acssca/Oxygen/CCCF GB/GB4717/2020/02_草案稿解析/GB4717-201X CCCF-update_20181226.pptx

- GB4717-201X Key Changes
- 2018.12.26

## 20181221 国标讨论会议重点摘要

- 指示灯及对应文字的展现形式在保持总体布局、功能的前提下，可以调整其大小，形状。
- 增加事件确认按键，对所有事件作确认（可以有全局确认和单一确认），确认后的事件带有已确认文字标识，不影响指示灯和蜂鸣器状态。确认操作与手自动操作无关。火警确认可通过操作联动启动按钮来完成，其他事件仍需做确认操作。
- 检查功能更改为由按键实现，不设操作级别，设检查指示灯。
- 手自动切换操作和联动启动按键的功能要求与上一版报批稿一致。（钥匙设为手动档，联动启动按钮按下后系统切换为自动状态。在下一次复位后，按照钥匙的实际位置，更新系统的手自动状态。）
- 联动启动按键的颜色更改为绿色。
- 屏蔽和监管仍作为可选功能。
- 保留‘系统故障’指示灯的描述。


联动
启动

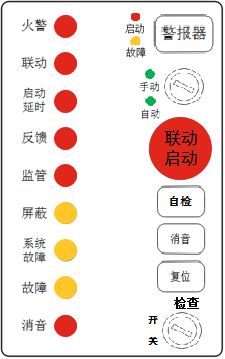
[picture p16: figure]
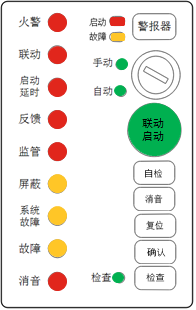
[picture p17: figure]
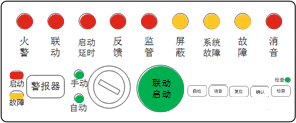
[picture p18: figure]

## 20181221 国标讨论会议重点摘要

- 统一外设部件的名称，全称和缩写，以及所属的事件类别。编码方式不做统一规定。
- 控制器软件界面不做强制统一要求。
- 增加‘调试接口’，使用企业专用工具，使控制器进入调试模式， 此阶段产生的事件信息应标识为调试信息。（可选）
- 在控制器上植入使用说明书或操作指南。（后续考虑）
- 为集中型控制器增加‘复视显示器’，尺寸大于17寸。应能通过该显示器实现集中控制器的所有功能。
- 历史记录总数上限为所接探测器数量的100倍，事件分类存储。（征询意见）
- 多线输出的启停按钮，应有物理方式防止两个按键同时按下，不接受同时按下后不输出的方式。

标签

## 20181207操作面板更新

联动
启动

更新内容：
- 增加自检按钮
- 移除检查指示灯
- 调整按键布局
- 调整指示灯和文字标识


联动
启动

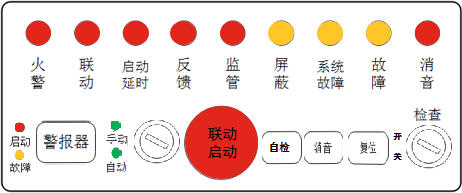
[picture p19: figure]

现场反馈问题：
- 联动启动按钮和手自动钥匙的状态一致性问题
- 使用钥匙进行检查时，与系统其他状态之间的转换问题
- 复位，消音等功能按键布局过于靠近，容易误操作

## 20180509 update

- 5.4.1.6 控制器应能手动消除火灾报警声信号，消声后，应点亮消音指示灯；有新的火灾报警信号输 入时，声警报信号应能重新启动，并熄灭消音指示灯。
- 5.4.2.6 控制器应能手动消除和启动火灾声和/或光警报器的声警报信号，并能指示声警报信号的启
动状态。
5.4.1.10 控制器应设手动复位按钮（键），操作手动复位按钮（键），控制器应在 20 s 内完成复位； 复位后，仍然存在的状态及相关信息均应保持或在 20 s~~（~~~~60s~~~~）~~ 内重新建立
  - 20秒重建事件对3030控制器有较大影响
  - 集中机在显示网络事件时是否也需要满足这个时间要求？
- 5.4.5.2 当有监管信号输入时，控制器应在 100 s 内发出与火灾报警信号有明显区别的监管报警声、光 信号；声信号应能手动消除，当有新的监管信号输入时应能再启动；光信号应保持至手动复位。 如监管信号仍存在，复位后监管报警状态应保持或在 60 s~~（~~~~20s~~~~）~~ 内重新建立。
- 5.4.9.3 当显示区域不足以显示全部检查信息时，应设手动查询按钮（键），每手动查询一次，只能查 询一条检查信息。
  - 检查信息中设备类别的划分（按设备大类分，还是要具体到软件类型？）
  - 手动查询一次，只能查询一条检查信息，如何定义“一条检查信息”？

## 20180509 update

- 5.4.2.4 控制器应设置其它控制输出（不应少于 2 点，且不大于 6 点），用于控制火灾报警传输设备和消防联动设备等设备，并满足下述要求：
a) 每一控制输出应具有可编程功能，报警区域内符合联动控制触发条件的两只火灾探测器，或一 只火灾探测器和一只手动火灾报警按钮发出火灾报警信号时，控制器应发出启动输出信号；
b) 每一控制输出应有对应的绿色手动直接启动按钮（键）和红色手动直接停止按钮（键），控制 器不应采用软件方式实现手动直接启动按钮（键）和手动直接停止按钮（键）的控制功能。控 制器应具有防止手动直接启动按钮（键）和红色手动直接停止按钮（键）同时动作的措施。
  - 我们的理解为：多线控制输出点，既可以通过逻辑方程进行联动输出，同时也支持通过独立的手动“启动/停止”按钮进行控制，手动控制优先。“启动”按钮和“停止”按钮不能同时按下（如同时按下不生效是否可以？）。手动控制应通过硬件方式实现。
  - 可编程功能与多线输出按钮的“允许/禁止”钥匙之间的关系?在禁止状态下，是否能联动输出？
  - 可编程功能与控制面板上的“联动启动”按钮之间的关系?联动生效后，是否还需要按下“联动启动按钮”？
  - 可编程功能与控制面板上的“手动自动”钥匙之间的关系?联动生效后，是否还需要系统处于自动状态才能输出？
5.4.10.1 控制器应采用 RS485 总线接口、CAN 总线接口、RJ45 以太网接口中的一种或多种接口同消防控制室图形显示装置通信，向消防控制室图形显示装置发送信息。通信接口应具有防脱落措施。

## 报警和联动总线

- 4.7 消防系统报警总线 FAbus（fire system alarm bus）
火灾自动报警系统中，火灾报警触发器件与火灾报警控制装置之间传送信息的通信线路。
- 4.8 消防系统联动总线 FCbus（fire system control bus）
火灾自动报警系统中，火灾报警控制器（联动型）与输出模块、输入模块、输入/输出模块之间 传送信息的通信线路。
- FA和FC总线的数量，标准未要求和限制。可根据需求配置端口，但作为报警总线的端口，不能连接联动总线设备。反之亦然。 （2017反馈意见）
- 报警总线和联动总线的数量及容量，有可能会写入检测报告，会从一定程度影响系统的容量
- 报警总线和联动总线从接线端子上分开，但仍在一个物理回路卡上，是否可以？

## 消防设备控制总线

- 4.9 消防系统设备控制总线 FECbus（fire system equipment control bus）
火灾自动报警系统中，火灾报警控制器（联动型）通过消防联动通信模块与消火栓系统、自动灭火系统、防排烟系统、防火卷帘监控系统、防火门监控系统、消防应急广播、消防应急照明和疏散指示系统等消防联动控制设备之间传送信息的通信线路。
- 5.3.1.6 控制器的通信线路应采用铜质绞线或光缆连接，控制器的消防系统设备控制总线应采用独 立的通信线路，不应与消防系统报警总线、消防系统联动总线复用.
- C.3.2.1 消防联动通信模块应具有CAN总线标准接口、RS485标准接口两种总线通信接口。消防联 动控制设备可通过任一接口与消防联动通信模块连接，通信接口应采用接线端子的连接方式。
- C.3.2.2 火灾报警控制器（联动型）与消防联动控制设备通信时，火灾报警控制器（联动型）应为 主控节点，负责接收网络内各子系统节点的上传信息，下发控制和管理信息。火灾报警控制器 （联动型）的地址编号应为1，消防联动控制设备的地址编号应为2～63。
- C.3.2.3 消防联动控制设备的通信链路中，任一点断路或短路时，火灾报警控制器（联动型）与消 防联动控制设备应能正常通信。

通信链路指的是联防联动设备同FECM之间的通信链路

## 与消防控制室图形显示装置通信功能

- 5.4.10 与消防控制室图形显示装置通信功能
- 5.4.10.1 控制器应采用 RS485 总线接口、CAN 总线接口、RJ45 以太网接口中的一种或多种接口 同消防控制室图形显示装置通信，向消防控制室图形显示装置发送信息。通信接口应具有防脱 落措施。
- C.3.1.2 火灾自动报警系统设备与消防控制室图形显示装置应采用一对一的主从通信方式，火灾自 动报警系统设备为主机，消防控制室图形显示装置为从机，如多台火灾自动报警系统设备接入 同一消防控制室图形显示装置，消防控制室图形显示装置需扩展多个接口。
- 5.4.10.2 当有火灾报警信号、监管报警信号、屏蔽信号、故障信号输入时，控制器应向消防控制室
图形显示装置发送输入信号的类别、名称、部位、位置、时间、工作状态（正常工作状态、火 灾报警状态、屏蔽状态以及故障状态）等信息。
- 5.4.10.3 控制器输出通信协议应满足附录 C 的要求。

考虑开发多口的接口卡？

启动和反馈信号，参考GB16806

## 消防系统设备控制总线通信协议

- C.1.1 本协议适用于以下设备与消防控制室图形显示装置的通信：
a) 火灾报警控制器；
b) 火灾报警控制器（联动型）；
c) 消防联动控制器；
d) 电气火灾监控设备；
e) 可燃气体报警控制器；
f) 应急照明控制器；
g) 消防设备电源状态监控器；
h) 防火门监控器。
- C.1.2 本协议适用于以下消防联动控制系统通过消防联动通信模块与火灾报警控制器（联动型）的通信：
a) 消火栓系统；
b) 自动灭火系统；
c) 防烟、排烟系统
d) 防火卷帘系统；
e) 防火门监控系统；
f) 消防应急广播；
g) 消防应急照明和疏散指示系统；
h) 其它受消防联动控制的系统或设备。

## 理解中的系统拓扑图

- 使用回路通信的楼显、声光、或安防设备等以后如何连接？

- 报警总线和联动总线在接线上独立分开，但能否仍在同一个物理回路上？
- 第三方子系统通讯协议统一后，是否还需要和控制器做系统间的配接试验？

FAbus

S

I/M

H

O/M

MCP

图形显示装置

CAN/485/Ethernet

L
C
M

DSP

FCbus

I.O/M

SWITCH

FACP

CAN/485/Ethernet

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
FACP

NCM

转发所有控制器及报警子系统上的报警信息，以及FECbus上的联动信息

应急照明控制器

可燃气体报警控制器

CAN/485/Ethernet

FECM

1#

FEC Panel

CAN & 485

CAN & 485

消防系统设备控制
总线通信协议

FACP

CAN/485/Ethernet

NCM

电气火灾监控设备

防火门监控器

消防系统设备控制总线通信协议

消防设备电源状态监控器

FECM

防火门监控系统

CAN & 485

FECbus

2#

FECM

消防应急广播

3#

FECM

消火栓系统

4#

FECM

自动灭火系统

5#

FECM

防火卷帘系统

6#

7#

FECM

防烟、排烟系统

62#

FECM

消防应急照明和疏散指示系统

63#

FECM

其它受消防联动控制的系统或设备

## 联动型控制器要求

- 5.4.2.11 控制器在机箱内设有消防联动控制设备时，即火灾报警控制器（联动型），还应满足 GB
16806 中消防联动控制器的相关要求，消防联动控制设备故障不应影响控制器的火灾报警功能和 非故障部位的火灾报警控制功能。
- 5.4.2.12 火灾报警控制器（联动型）应能接收来自火灾探测器及其它火灾报警触发器件的火灾报警信
号，指示火灾发生部位和发生时间，并将火灾报警部位信息发送给消防联动控制设备。
- 5.4.2.13 火灾报警控制器（联动型）应能指示其连接的消防电气控制装置的手动/自动控制状态信息。
- 5.4.2.14 火灾报警控制器（联动型）应通过消防联动通信模块与消防联动控制设备通信，消防联动通
信模块应具有 CAN 接口、RS485 接口两种总线通信接口。与消防联动通信模块连接的消防联动 控制设备总数不应大于 63 个。消防联动通信模块与消防联动控制设备的通信协议应满足附录 C 的要求。

## 操作面板

- 5.3.1.5 控制器应具有中文功能标注和信息显示，按键与指示灯应采用图1或图2的设置方式
- 5.3.2.1 应以红色指示火灾报警状态、监管状态、反馈信号、向火灾报警传输设备传输信号和向消防
联动设备输出控制信号；黄色指示故障、屏蔽、自检、消音状态；绿色指示电源工作状态、手动工作 状态、自动工作状态、检查功能状态。
- 5.4.2.2 控制器应设置手动/自动状态转换钥匙、手动控制状态指示灯（器）和自动控制状态指示灯（器）
- 5.4.2.3 控制器应设置独立的联动控制启动按钮（键），按钮（键）应采用直径不小于 12 mm 的圆形红 色按钮（键）。按键应具有防止误操作的措施，不应采用密码保护的方式。当控制器处于手动控制状 态时，应能通过手动操作该按钮（键），转换到自动控制状态，并点亮自动控制状态指示灯（器）。

根据2017报批稿反馈意见：
- 门锁钥匙和控制面板上的两把钥匙应统一。
- 面板仅规定布局要求。各厂商在满足布局要求的情况下，可自行设计。
- 防止误操作的方式不能是软件方式
- 如果钥匙设为手动档，联动启动按钮启动后系统为自动状态，此状态下，表明在手动状态下，操作了联动启动按键。复位后，按照钥匙的位置设置，设为手动状态。

联动
启动

联动
启动

- 系统处于自动状态时，联动输出是否还要受联动启动按钮控制？
- 联动启动声光、联动启动多线输出，是否受联动启动按钮的控制？
- 输出延时是否需要点亮或闪亮启动延时指示灯？报警延时是否需要点亮或闪亮启动延时指示灯或其他指示？指示灯的颜色是否要求为红色？

## 运行数据存储单元

4.6 运行数据存储单元 operational data storage unit
用于记录控制器连接的全部火灾报警触发器件、消防联动设备的运行状态信息，为火灾调查提 供参考的单元。
5.3.9 运行数据存储单元
控制器的运行数据存储单元应为独立可拆卸结构，采用金属外壳，外壳防护等级（IP代码）不 应低于GB/T 4208中IP54的要求，功能应满足附录A 的要求。
5.4.3.4 控制器应能显示下述故障的类型：
d) 控制器不能对运行数据存储单元保存数据。

- 历史记录存放在运行数据存储单元中，无需额外的历史记录功能。（2017报批稿反馈意见）

Honeywell Internal

## 运行数据存储单元--数据记录功能

- A.1.1 数据记录功能
- A.1.1 .1 控制器运行数据存储单元应能记录如下消防设备运行状态信息:
a) 与控制器连接的全部火灾报警触发器件的火灾报警信息、屏蔽信息、故障信息、监管信息、 手/自动状态信息等消防设备运行状态信息；
b) 联动控制启动按钮（键）的动作信息；
c) 与控制器连接的消防联动设备的启动信息、反馈信息、屏蔽信息、故障信息、手动/自动状态 信息等消防设备运行状态信息；
d) 控制器的开、关机和复位、检查、时钟调整的操作信息；
e) 集中型控制器所连接区域型控制器的 a)～d)规定的信息。
- A.1.1.2 控制器每产生一次新的数据记录的同时，控制器运行数据存储单元应同步记录对应的年、 月、日、时、分、秒等时间信息；并应具有按照时间顺序提供导出记录信息的功能。
- A.1.1.3 控制器运行数据存储单元应有防止存储信息被更改或删除的功能。

## 运行数据存储单元--数据存储功能

- A.1.2 数据存储功能
- A.1.2.1 控制器运行数据存储单元的存储的记录容量应满足下述要求：
a) 记录的火灾报警信息数目不小于控制器连接的火灾报警触发器件数目的 3 倍；
b) 记录的消防设备运行状态信息数目不小于控制器连接的火灾报警触发器件与消防联动设备 数目之和的 5 倍。
- A.1.2.2 控制器记录的消防设备运行状态信息超出运行数据存储单元的记录容量后，应始终保持最 新的状态信息记录。首火警信息和火灾报警信息应独立记录，其它消防设备运行状态信息不应 覆盖首火警信息和火灾报警信息。
- A.1.2.3 控制器运行数据存储单元应采用十六进制格式进行数据存储，数据存储格式见表A.1。

## 运行数据存储单元--数据导出功能

- A.1.3 数据导出功能
- A.1.3.1 应仅能用专用技术手段将控制器运行数据存储单元记录的信息导出。数据导出格式与数据 储存格式相同，见表A.1.
- A.1.3.2 应至少提供USB B型接口（母口）或USB C型接口（母口）进行数据导出，USB接口应支 持USB2.0标准的从机模式（Device）。
- A.1.3.3 数据导出命令格式见表A.3。

## 运行数据存储单元--数据安全保护功能

- A.1.4 数据安全保护功能
- A.1.4.1 控制器运行数据存储单元数据的存储不受控制器工作状态的影响。
- A.1.4.2 控制器运行数据存储单元应在授权后才能导出和回放存储的信息。
- A.1.4.3 控制器运行数据存储单元应能承受标称工作电压的120％的反向工作电压1min，试验后数 据记录、存储及导出功能正常。
- A.1.4.4 在火灾报警控制器断电后，控制器运行数据存储单元应自动进入保护状态，断电前存储的 数据应保持14d以上不丢失。
- A.1.4.5 控制器运行数据存储单元所有接口在非使用状态下应配置有效的保护装置。

- 授权方式如何定义？
- 控制器能否对存储单元进行读取，如果是，那么如何授权？

- 存储单元被取走后，是否需要有告警提示？
- 控制器是否可以额外保存一份历史记录，用于实时读取？

## 检查功能

- 5.4.9 检查功能
- 5.4.9.1 控制器应设置独立的检查功能钥匙和检查功能状态指示灯（器），控制器处于检查功能状 态时，应点亮检查功能状态指示灯（器）。检查功能钥匙的操作不受操作级别的限制，应能通 过手动操作钥匙，显示以下信息：
a) 控制器连接的所有工程设计设备类别和地址总数；
b) 控制器连接的所有正常工作设备类别和地址总数；
c) 控制器接收的故障设备类别和地址总数；
d) 控制器已屏蔽设备的类别和地址总数。
  - 不强制要求按总线通道显示数量（2017报批稿反馈意见）
- 5.4.9.2 控制器显示的工程设计设备类别和地址总数输入后，不应受 5.4.9.1 中 b)、c)、d)的总数 调整的影响。
- 5.4.9.3 当显示区域不足以显示全部检查信息时，应设手动查询按钮（键），每手动查询一次，只 能查询一条检查信息。
- 5.4.9.4 控制器处于检查功能状态时，应能显示后续接收到的火灾报警信息。

数量\ 设备类型 | 设计数量 | 正常工作数量 | 故障数量 | 屏蔽数量
探测器 | 50 | 35 | 10 | 5
手报 | 10 | 5 | 2 | 3
输入模块 | 50 | 40 | 5 | 5
输出模块 | 50 | 50 | 0 | 0
总数 | 160 | 130 | 17 | 13

- 检查钥匙在开启状态，则检查功能始终有效。火警消除后，继续进入检查状态。（2017报批稿反馈意见）

## 其他要求

- 5.3.1.7 控制器外壳为非金属材料时，外壳材料的阻燃等级应为 GB/T 2408—2008 中的 V0 级。 控制器的外壳防护等级（IP 代码）不应低于 GB/T 4208 中 IP30 的要求。
- 5.4.1.11 控制器火灾报警计时装置的日计时误差不应超过 6 s~~（~~ ~~30s~~ ~~）~~，使用打印机记录火灾报警 时间时，应打印出年、月、日、时、分等信息，但不能仅使用打印机记录火灾报警时间。
- 5.4.4.2 控制器不应屏蔽火灾声和/或光警报器
- 5.4.4.7 屏蔽状态不应受控制器复位、开/关机等操作的影响
- 7.1 产品出厂检验
企业在产品出厂前应对控制器进行下述试验项目的检验:
h) 检查功能试验
i) 同消防控制室图形显示装置通信功能试验

- 出厂检测时增加的图形装置通信功能试验，是否表示图显是必须的产品？

## 试验要求

- 6.1.5 绝缘电阻
控制器的外部带电端子和电源插头的工作电压大于50 V时，外部带电端子和电源插头与外壳间的 绝缘电阻在正常大气条件下不应小于100 MΩ。~~（~~~~50 MΩ~~ ~~）~~
- 6.2.1 电快速瞬变脉冲群抗扰度试验
重复频率 AC 电源线 ：5×(1±0.2)KHz ~~2.5×~~~~（~~~~1±0.2~~~~）~~
- 6.2.7 恒定湿热（耐久）试验(不通电状态)
温度 40±2 ℃
相对湿度 93±3%（~~90-95~~~~%~~~~）~~
持续时间 21d

## 问题列表1

- 操作面板
  - 系统处于自动状态时，联动输出是否还要受联动启动按钮控制？
  - 手动状态下火警联动启动声光、是否需要通过联动启动按钮来控制？
  - 联动启动按钮，非密码方式的保护措施，是否指的是物理保护罩？
- 多线控制盘
  - 理解为：多线控制点在支持手动开关的同时，也支持通过编程进行逻辑联动
  - 独立的启停开关不能同时按下的需求，一定要求机械方式实现（停止键按下，启动键弹起）？是否可以通过设计达到同时按下不响应来实现？
  - 手动开关是否优先于逻辑联动？联动生效后，手动可以关闭？
  - 多线盘上如果配置有按键锁，锁止后，是否还可以被可编程联动输出？
  - 多线盘通过编程进行联动输出时，是否受控制器手自动状态的影响？如果在手动状态下，是否受联动启动按钮的控制？
