acssca/Oxygen/CCCF GB/GB4717/2020/03_概念设计稿/N-6000P-2019-03-11/N-6000P 立柜总装图.JPG

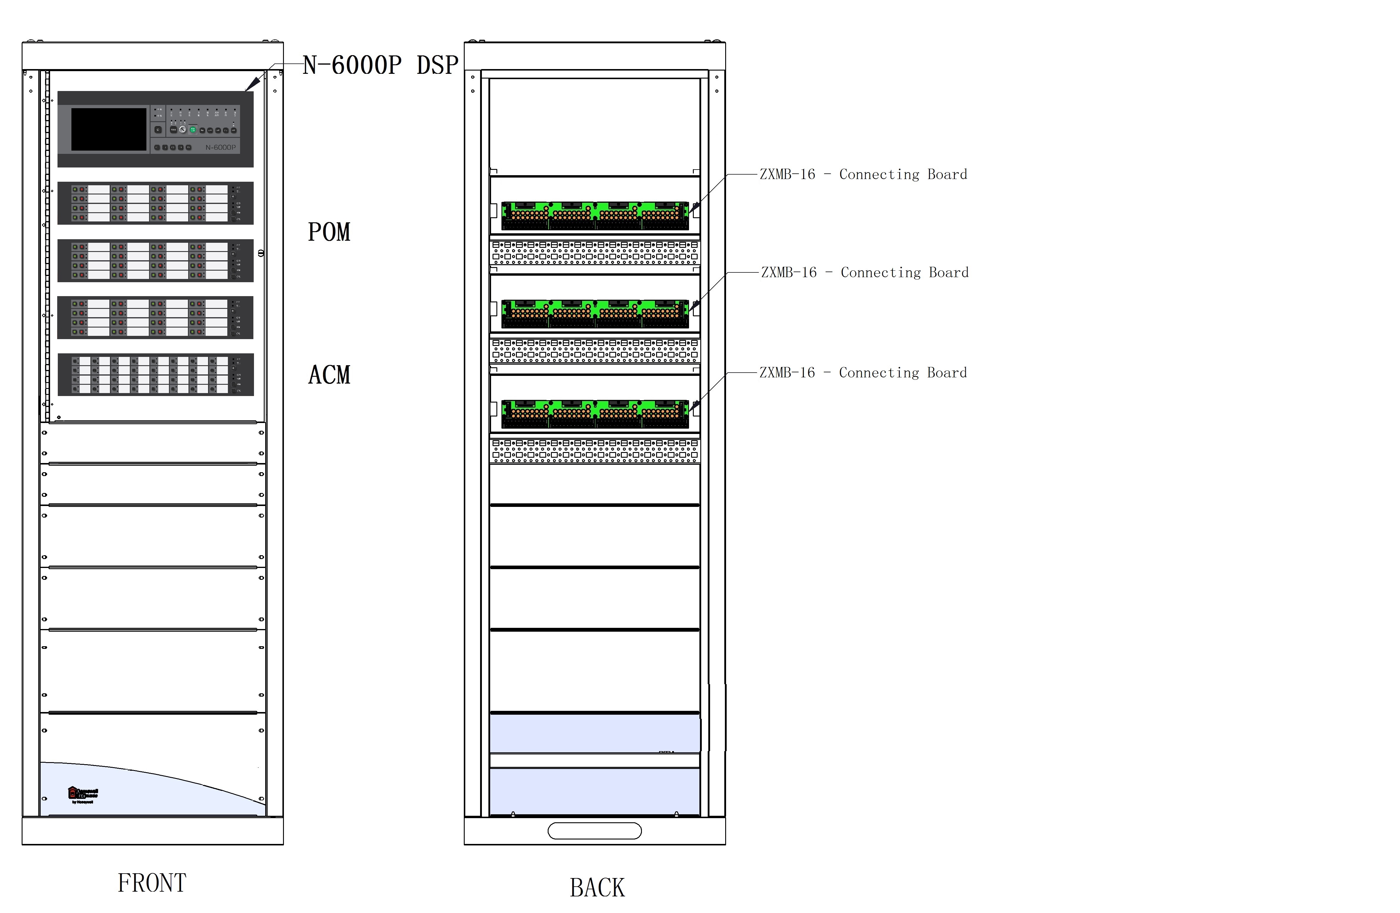
CCCF GB/GB4717/2020/03_概念设计稿/N-6000P-2019-03-11/N-6000P 立柜总装图.JPG
