acssca/Oxygen/CCCF GB/GB4717/2020/03_概念设计稿/N-6000P-2019-03-11/N-6000P-190311-02.jpg

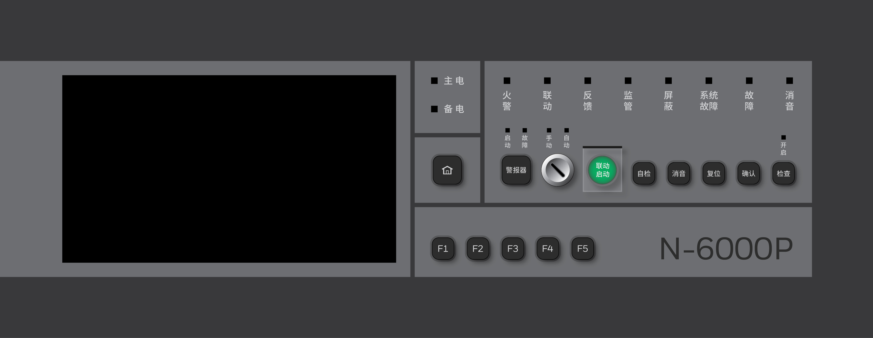
CCCF GB/GB4717/2020/03_概念设计稿/N-6000P-2019-03-11/N-6000P-190311-02.jpg
