acssca/Oxygen/Hardware/Main Board/V1.0/PTWxxx_MB_V1.0_BOM_20210205.xlsx

 | 所属项目： | PTW3300S+_MB
 | 负责人： |  |  |  | * 编号一次分配，不可改变，删除的项编号废弃
 | 版本号： | V1.0 |  |  | * 规格描述格式采用 值-耐压-精度-温度
 | 时间： | 2021.02.05 |  |  | * 物品类型参照ERP中导出的物料分类表和原料表
 | 作者： | chen |  |  | * 工程版本号XX.XX, Release版本号XX.00, 版本文件命名：项目名_BOM名_BOM_版本号.xml
N0. | Name | Value | Manufacturer | Description | PCB Footprint | Reference | Quantity | CPN | Notice
编号 | 物料名称 | 型号 | 制造商 | 规格描述 | 封装 | 参考 | 数量 | ERP编码 | 备注
1 | 贴片电阻 | 0603WAF499JT5E | UniOhm台湾厚声 | 49.9 1% | r_0603 | R1 | 1
2 | 贴片电阻 | 0603WAF3653T5E | UniOhm台湾厚声 | 365K 1% | r_0603 | R2 | 1
3 | 贴片电阻 | 0603WAF5362T5E | UniOhm台湾厚声 | 53.6K 1% | r_0603 | R3 | 1
4 | 贴片电阻 | 0603WAF1152T5E | UniOhm台湾厚声 | 11.5K 1% | r_0603 | R4 | 1
5 | 贴片电阻 | 0603WAF8662T5E | UniOhm台湾厚声 | 86.6K 1% | r_0603 | R5 | 1
6 | 贴片电阻 | 0603WAF1623T5E | UniOhm台湾厚声 | 162K 1% | r_0603 | R6 | 1
7 | 贴片电阻 | 0603WAF1022T5E | UniOhm台湾厚声 | 10.2K 1% | r_0603 | R7 | 1
8 | 贴片电阻 | 0603WAJ0103T4E（NC） | UniOhm台湾厚声 | NC | r_0603 | R8,R10,R11,R12,R14,R15,R16,R19,R20,R21,R22,R23,R27,R30,R34,R35,R40,R41,R42,R44,R45,R47,R51,R54,R56,R59,R60,R61,R63,R67,R69,R71,R72,R73,R74,R76 | 36
9 | 贴片电阻 | 0603WAJ0103T5E | UniOhm台湾厚声 | 10K 5% | r_0603 | R9,R13,R17,R18,R24,R25,R26,R28,R29,R31,R32,R33,R36,R37,R38,R39,R43,R46,R48,R49,R50,R52,R53,R55,R57,R58,R62,R64,R65,R66,R68,R70,R75,R77,R78,R79,R87,R88,R90,R91,R93,R98 | 42
10 | 贴片电阻 | 0603WAJ0472T5E | UniOhm台湾厚声 | 4.7K 5% | r_0603 | R80,R81,R82,R83,R84,R85,R86,R89,R94 | 9
 | 贴片电阻 | 1206W4J0204T5E | UniOhm台湾厚声 | 200K 5% | R_1206 | R97 | 1
11 | 贴片电阻 | 1206W4J0105T5E | UniOhm台湾厚声 | 1M 5% | R_1206 | R92,R95,R96 | 3
12 | 贴片电容 | 0603B104K500NT | FH(风华) | 100nF 50V | c_0603 | C1,C4,C5,C11,C13,C14,C15,C16,C17 | 9
13 | 贴片电容 | 0603F105M500NT | FH(风华) | 1uF 50V | c_0603 | C3 | 1
14 | 贴片电容 | 0603CG470J500NT | FH(风华) | 47pF 50V | c_0603 | C9 | 1
15 | 贴片电容 | 0603B562K500NT | FH(风华) | 5.6nF 50V | c_0603 | C10 | 1
16 | 贴片电容 | CC0603KRX5R9BB225 | YAGEO(国巨) | 2.2uF 50V | c_1210 | C7,C8 | 2
17 | 贴片电容 | TAJB107K006RNJ | AVX | 100uF 6.3V | c_3528 | C12 | 1
18 | 高压电容 | 1206B102K202NT | FH(风华) | 1nF 2KV | c_1206 | C18 | 1
19 | 贴片电解电容 | RVE1C221M0607 | ROQANG(容强) | 220uF 16V | SMD,6.3x7.7mm | C2 | 1
20 | 贴片电解电容 | RVE1H221M1010 | ROQANG(容强) | 220uF 50V | SMD,10x10.2mm | C6 | 1
21 | 贴片功率电感 | SMNR5030-5R6N | SXN(顺翔诺) | 5.6uH 3A | 5.0*5.0*3.0 | L1 | 1
22 | 贴片磁珠 | GZ1608D601TF | Sunlord(顺络) | 100M@600ohm | r_0603 | FB1 | 1
23 | 贴片TVS | SMBJ6.5CA | RUILON(瑞隆源) | SMBJ6.5CA | smb | D9,D12,D13,D15,D16,D17,D18,D19,D20 | 9
24 | 贴片TVS | SMBJ15CA(NC) | RUILON(瑞隆源) | SMBJ15CA NC | smb | D1,D2,D3,D156,D157,D158 | 6
25 | 贴片TVS | SMBJ40CA(NC) | RUILON(瑞隆源) | SMBJ40CA NC | smb | D4,D5,D6 | 3
26 | 贴片TVS | SMBJ15CA | RUILON(瑞隆源) | SMBJ15CA | smb | D10,D14,D21,D22,D23,D25,D26 | 7
27 | 贴片TVS | SMBJ33CA | RUILON(瑞隆源) | SMBJ33CA | smb | D8,D11,D24 | 3
28 | 贴片TVS | SMBJ40CA | RUILON(瑞隆源) | SMBJ40CA | SMB | D27,D28,D29,D30,D31,D32,D33,D34,D35,D36,D37,D38,D41,D42,D45,D46,D49,D50,D51,D52,D53,D54,D55,D56,D57,D58,D59,D60,D61,D62,D69,D70,D71,D72,D73,D74,D75,D76,D77,D78,D79,D80,D81,D82,D83,D84,D85,D86,D89,D90,D93,D94,D97,D98,D99,D100,D101,D102,D103,D104,D105,D106,D107,D108,D109,D110,D117,D118,D119,D120,D121,D122,D123,D124,D125,D126,D127,D128,D130,D131,D134,D135,D136,D137,D139,D140,D141,D142,D143,D144,D145,D146,D151,D152,D153,D154 | 96
29 | 肖特基二极管 | SS26T3G | ON(安森美) | Vr=60V Io=2A | SMB | D7,D155 | 2
30 | 普通二极管 | 1N4007W | 晶导微电子 | 1N4007W | SOD-123FL | D39,D43,D47,D87,D91,D95,D138,D132,D159,D160 | 10
31 | 贴片三极管 | MMBT5551LT1G | ON(安森美) | NPN | sot-23 | Q1,Q2,Q3,Q4,Q5 | 5
32 | 自恢复保险丝 | SMD1812P050TF/30 | RUILON(瑞隆源) | 500mA 30V | 1812 | F1 | 1
33 | PCIE座子 | 3113-111T | UMaxconn | PCIE34 | slt_pcie64_molex-smd | CN1,CN2,CN3,CN4,CN5,CN6,CN7,CN8,CN9,CN10,CN11,CN12,CN13 | 13
34 | 牛角座 | DC3-40P | 无 | 1.27mm 2*20P SMD 直座 | DC3_40p_1r27 | J1 | 1
35 | 牛角座 | DC3-26P | 无 | 1.27mm 2*13P SMD 直座 | DC3_26p_1r27 | J2 | 1
36 | 2EDG座子 | WJ2EDGVC-5.08-2P | KANGNEX(康奈克斯电气) | 直座 带边 绿色 5.08mm 2P | WJ2EDGV-5r08-2P | J3,J7 | 2
37 | 2EDG座子 | WJ2EDGVC-5.08-4P | KANGNEX(康奈克斯电气) | 直座 带边 绿色 5.08mm 4P | WJ2EDGVC-5r08-4P | J4,J6,J10,J11,J15,J16,J17,J21,J22,J23,J26,J27 | 12
38 | 2EDG座子 | WJ2EDGRC-5.08-4P | KANGNEX(康奈克斯电气) | 弯座 带边 绿色 5.08mm 4P | WJ2EDGRC-5r08-4P | J5,J8,J9,J12,J13,J14,J18,J19,J20,J24,J25 | 11
39 | 信号继电器 | HFD4/5-S | HF(宏发) | SMD 5V | relay_hf_5v | K1,K2,K3,K4,K5,K6,K7,K8,K9,K10,K11,K12,K13,K14,K15,K16,K17,K18,K19,K20,K21,K22,K23,K24,K25,K26,K27,K28,K29,K30,K31,K32,K33 | 33
40 | DCDC芯片 | TPS54340DDAR | TI(德州仪器) | TPS54340DDA | SOIC_8_EP_150mil | U1 | 1
41 | LDO芯片 | AMS1117-3.3 | 美国AMS | AMS1117-3.3 | sot223 | U2 | 1
42 | 逻辑芯片 | SN74HC138DR | TI(德州仪器) | 74HC138 | SOIC-16 | U3 | 1
43 | 逻辑芯片 | SN74HC14D | TI(德州仪器) | 74HC14D | soic-14_150mil | U4,U6 | 2
44 | 驱动芯片 | ULN2803ADWR | TI(德州仪器) | ULN2803A | SOP-18_300mil | U5 | 1
配件
1 | 2EDG端子 | WJ2EDGKB-5.08-2P | KANGNEX(康奈克斯电气) | 绿色 直头 5.08mm 2P 曲边与出线同向 | 无 | J3,J7 | 2
2 | 2EDG端子 | WJ2EDGKB-5.08-4P | KANGNEX(康奈克斯电气) | 绿色 直头 5.08mm 4P 曲边与出线同向 | 无 | J4,J6,J10,J11,J15,J16,J17,J21,J22,J23,J26,J27 | 12
3 | 2EDG端子 | WJ2EDGK-5.08-4P | KANGNEX(康奈克斯电气) | 绿色 弯头 5.08mm 4P | 无 | J5,J8,J9,J12,J13,J14,J18,J19,J20,J24,J25 | 11
