acssca/Oxygen/CCCF GB/GB4717/2020/02_草案稿解析/Design Changes for New CCCF.xlsx

Sheet: Requirements & Issues
Req.No. | Summary | M/O | Comment | Category | Assigned User | Primary Estimated Effort | Priority | Start Date | Due Date | Status
#1 | 消音操作 | Mandatory | 5.4.1.6 控制器应能手动消除火灾报警声信号，消声后，应点亮消音指示灯； 有新的火灾报警信号输入时，声警报信号应能重新启动，并熄灭消音指示灯。 消音是消本地声音 | Software
#2 | 声光控制 | Mandatory | 5.4.2.6 控制器应能手动消除和启动火灾声和/或光警报器的声警报信号，并能指示声警报信号的启动状态。 警报器按钮用来启动/关闭所有声光设备，对应的启动灯是用来指示系统中任一声光警报器的启动状态。 | Software
#3 | 复位操作 | Mandatory | 5.4.1.10 控制器应在 20 s 内完成复位； 复位后，仍然存在的状态及相关信息均应保持或在 20 s内重新建立 集中机在显示网络事件时是否也需要满足这个时间要求？ | Software
#4 | 监管信号 | Mandatory | 5.4.5.2 当有监管信号输入时，控制器应在 100 s 内发出与火灾报警信号有明显区别的监管报警声、光 信号；声信号应能手动消除，当有新的监管信号输入时应能再启动；光信号应保持至手动复位。 如监管信号仍存在，复位后监管报警状态应保持或在 60 s内重新建立。 | Software
#5 | 手动查询 | Mandatory | 5.4.9.3 当显示区域不足以显示全部检查信息时，应设手动查询按钮（键），每手动查询一次，只能查 询一条检查信息。 检查信息中设备类别的划分（按设备大类分，还是要具体到软件类型？） 手动查询一次，只能查询一条检查信息，如何定义“一条检查信息”？ | Software
#6 | 多线控制输出 | Mandatory | 5.4.2.4 控制器应设置其它控制输出（不应少于 2 点，且不大于 6 点），用于控制火灾报警传输设备和消防联动设备等设备，并满足下述要求： a) 每一控制输出应具有可编程功能，报警区域内符合联动控制触发条件的两只火灾探测器，或一 只火灾探测器和一只手动火灾报警按钮发出火灾报警信号时，控制器应发出启动输出信号； b) 每一控制输出应有对应的绿色手动直接启动按钮（键）和红色手动直接停止按钮（键），控制 器不应采用软件方式实现手动直接启动按钮（键）和手动直接停止按钮（键）的控制功能。控 制器应具有防止手动直接启动按钮（键）和红色手动直接停止按钮（键）同时动作的措施。 理解为：多线控制点在支持手动开关的同时，也支持通过编程进行逻辑联动 独立的启停开关不能同时按下的需求，一定要求机械方式实现（停止键按下，启动键弹起）？是否可以通过设计达到同时按下不响应来实现？ 手动开关是否优先于逻辑联动？联动生效后，手动可以关闭？由后来的条件决定 多线盘上如果配置有按键锁，锁止后，是否还可以被可编程联动输出？ 多线盘通过编程进行联动输出时，是否受控制器手自动状态的影响？如果在手动状态下，是否受联动启动按钮的控制？ 5.多线输出的启停按钮，应有物理方式防止两个按键同时按下，不接受同时按下后不输出的方式 | SW&HW&ME
#7 | FABUS & FCBUS | Mandatory | FA和FC总线的数量，标准未要求和限制。可根据需求配置端口，但作为报警总线的端口，不能连接联动总线设备。反之亦然。 （2017反馈意见） 报警总线和联动总线的数量及容量，有可能会写入检测报告，会从一定程度影响系统的容量 报警总线和联动总线从接线端子上分开，但仍在一个物理回路卡上，是否可以？是必须分开的两条物理线路。 | SW&HW
#8 | FECBUS | Mandatory | 火灾自动报警系统中，火灾报警控制器（联动型）通过消防联动通信模块与消火栓系统、自动灭火系统、防排烟系统、防火卷帘监控系统、防火门监控系统、消防应急广播、消防应急照明和疏散指示系统等消防联动控制设备之间传送信息的通信线路 5.3.1.6 控制器的通信线路应采用铜质绞线或光缆连接，控制器的消防系统设备控制总线应采用独 立的通信线路，不应与消防系统报警总线、消防系统联动总线复用. C.3.2.1 消防联动通信模块应具有CAN总线标准接口、RS485标准接口两种总线通信接口。消防联 动控制设备可通过任一接口与消防联动通信模块连接，通信接口应采用接线端子的连接方式。 C.3.2.2 火灾报警控制器（联动型）与消防联动控制设备通信时，火灾报警控制器（联动型）应为 主控节点，负责接收网络内各子系统节点的上传信息，下发控制和管理信息。火灾报警控制器 （联动型）的地址编号应为1，消防联动控制设备的地址编号应为2～63。 C.3.2.3 消防联动控制设备的通信链路中，任一点断路或短路时，火灾报警控制器（联动型）与消 防联动控制设备应能正常通信。 | SW&HW
#9 | NCS通信 | Mandatory | 5.4.10.1 控制器应采用 RS485 总线接口、CAN 总线接口、RJ45 以太网接口中的一种或多种接口 同消防控制室图形显示装置通信，向消防控制室图形显示装置发送信息。通信接口应具有防脱 落措施。 C.3.1.2 火灾自动报警系统设备与消防控制室图形显示装置应采用一对一的主从通信方式，火灾自 动报警系统设备为主机，消防控制室图形显示装置为从机，如多台火灾自动报警系统设备接入 同一消防控制室图形显示装置，消防控制室图形显示装置需扩展多个接口。 5.4.10.2 当有火灾报警信号、监管报警信号、屏蔽信号、故障信号输入时，控制器应向消防控制室 图形显示装置发送输入信号的类别、名称、部位、位置、时间、工作状态（正常工作状态、火 灾报警状态、屏蔽状态以及故障状态）等信息 协议也采用FECBUS | SW&HW
#10 | 操作面板 | Mandatory | 1.指示灯及对应文字的展现形式在保持总体布局、功能的前提下，可以调整其大小，形状 3.检查功能更改为由按键实现，不设操作级别，设检查指示灯。 4.钥匙设为手动档，联动启动按钮按下后系统切换为自动状态。在下一次复位后，按照钥匙的实际位置，更新系统的手自动状态。 5.联动启动按键的颜色更改为绿色。 6.屏蔽和监管仍作为可选功能。 7.指示灯及对应文字的展现形式在保持总体布局、功能的前提下，可以调整其大小，形状。 系统处于自动状态时，联动输出是否还要受联动启动按钮控制？ 手动状态下火警联动启动声光、是否需要通过联动启动按钮来控制？ 联动启动按钮，非密码方式的保护措施，是否指的是物理保护罩？ | SW&HW&ME
#11 | 事件确认 | Mandatory | 增加事件确认按键，对所有事件作确认（可以有全局确认和单一确认），确认后的事件带有已确认文字标识，不影响指示灯和蜂鸣器状态。确认操作与手自动操作无关。火警确认可通过操作联动启动按钮来完成，其他事件仍需做确认操作。 | Software
#12 | 调试模式 | Optional | 增加‘调试接口’，使用企业专用工具，使控制器进入调试模式， 此阶段产生的事件信息应标识为调试信息 | Software
#13 | 在线手册 | Optional | 在控制器上植入使用说明书或操作指南。 | Software
#14 | 复视显示器 | Optional | 为集中型控制器增加‘复视显示器’，尺寸大于17寸。应能通过该显示器实现集中控制器的所有功能。 | SW&HW&ME
#15 | 运行数据 存储单元 | Mandatory | 1.控制器的运行数据存储单元应为独立可拆卸结构，采用金属外壳，外壳防护等级（IP代码）不 应低于GB/T 4208中IP54的要求 2. A.1.3.2 应至少提供USB B型接口（母口）或USB C型接口（母口）进行数据导出，USB接口应支 持USB2.0标准的从机模式（Device）。 3.历史记录存放在运行数据存储单元中，无需额外的历史记录功能。（2017报批稿反馈意见） A.1.4.3 控制器运行数据存储单元应能承受标称工作电压的120％的反向工作电压1min，试验后数 据记录、存储及导出功能正常。 A.1.4.4 在火灾报警控制器断电后，控制器运行数据存储单元应自动进入保护状态，断电前存储的 数据应保持14d以上不丢失。 A.1.4.5 控制器运行数据存储单元所有接口在非使用状态下应配置有效的保护装置。 授权方式如何定义？ 控制器能否对存储单元进行读取，如果是，那么如何授权？ 存储单元被取走后，是否需要有告警提示？ 控制器是否可以额外保存一份历史记录，用于实时读取？ | SW&HW&ME
#16 | 检查功能 System Check | Mandatory | 5.4.9.1 控制器应设置独立的检查按键和检查功能状态指示灯（器），控制器处于检查功能状 态时，应点亮检查功能状态指示灯（器）。检查功能的操作不受操作级别的限制，应能通 过手动操作，显示以下信息： a) 控制器连接的所有工程设计设备类别和地址总数； b) 控制器连接的所有正常工作设备类别和地址总数； c) 控制器接收的故障设备类别和地址总数； d) 控制器已屏蔽设备的类别和地址总数。 不强制要求按总线通道显示数量（2017报批稿反馈意见） 5.4.9.2 控制器显示的工程设计设备类别和地址总数输入后，不应受 5.4.9.1 中 b)、c)、d)的总数 调整的影响。 5.4.9.3 当显示区域不足以显示全部检查信息时，应设手动查询按钮（键），每手动查询一次，只 能查询一条检查信息。 5.4.9.4 控制器处于检查功能状态时，应能显示后续接收到的火灾报警信息 | Software
#17 | 计时误差 | Mandatory | 5.4.1.11 控制器火灾报警计时装置的日计时误差不应超过 6 s | SW&HW
#18 | 打印功能 | Optional | 使用打印机记录火灾报警 时间时，应打印出年、月、日、时、分等信息，但不能仅使用打印机记录火灾报警时间。 | Software
#19 | 屏蔽功能 | Optional | 1.控制器不应屏蔽火灾声和/或光警报器 2.屏蔽状态不应受控制器复位、开/关机等操作的影响 | Software
#20 | 试验要求 | Mandatory | 6.1.5 绝缘电阻 控制器的外部带电端子和电源插头的工作电压大于50 V时，外部带电端子和电源插头与外壳间的 绝缘电阻在正常大气条件下不应小于100 MΩ。 6.2.1 电快速瞬变脉冲群抗扰度试验 重复频率 AC 电源线 ：5×(1±0.2)KHz 6.2.7 恒定湿热（耐久）试验(不通电状态) 温度 40±2 ℃ 相对湿度 93±3% 持续时间 21d | Hardware
#21 | 产品出厂检验 | Mandatory | 企业在产品出厂前应对控制器进行下述试验项目的检验: h) 检查功能试验 i) 同消防控制室图形显示装置通信功能试验 出厂检测时增加的图形装置通信功能试验，是否表示图显是必须的产品？ | Testing

Sheet: 运行数据存储单元
Features 运行数据存储单元：用于记录控制器连接的全部火灾报警触发器件、消防联动设备的运行状态信息，为火灾调查提供参考的单元。
数据记录功能 | 1 | 与控制器连接的全部火灾报警触发器件的火灾报警信息、屏蔽信息、故障信息、监管信息、手动/自动状态信息等消防设备运行状态信息
 | 2 | 联动控制启动按钮（键）的动作信息
 | 3 | 与控制器连接的消防联动设备的启动信息、反馈信息、屏蔽信息、 故障信息、手动/自动状态信息等消防设备运行状态信息
 | 4 | 控制器的开、关机和复位、检查、时钟调整的操作信息
 | 5 | 每一条记录应同步记录对应的年、月、日、时、分、秒等时间信息， 并应具有按照时间顺序提供导出记录信息的功能。
 | 6 | 应有防止存储信息被更改或删除的功能
数据存储功能 | 7 | 记录的火灾报警信息数目不小于控制器连接的火灾报警触发器件数目的3倍
 | 8 | 记录的消防设备运行状态信息数目不小于控制器连接的火灾报警触发器件与消防联动设备数目之和的5倍
 | 9 | 控制器记录的消防设备运行状态信息超出运行数据存储单元的记录容量后，应始终保持最新的状态信息记录
 | 10 | 首火警信息和火灾报警信息应独立记录，其它消防设备运行状态信息不应覆盖首火警信息和火灾报警信息。 | 首火警在历史记录中是唯一的吗？
数据导出功能 | 11 | 至少可以通过USB进行数据导出，导出格式与存储格式相同
数据安全保护功能 | 12 | 控制器运行数据存储单元数据的存储不受控制器工作状态的影响
 | 13 | 控制器运行数据存储单元应在授权后才能导出和回放存储的信息

Sheet: 数据导出与存储格式
CRC16多项式：0xA001
 | 数据导出与存储格式
 | Field | 起始字符 | 记录总数 | Panel地址 | 类型 | 产品编号 | 数据信息 | CRC16 | 停止符
 | Bytes | 1 | 3 | 1 | 1 | 20 | n | 2 | 1 | 29
 | Data | 0X40 |  |  |  |  |  |  | 0x40
 | 数据信息格式
 | Field | 控制器编号 | 单元编号 | 设备编号 | 通道编号 | 设备类型代码 | 事件代码 | 状态代码 | 年 | 月 | 日 | 时 | 分 | 秒
 | Bytes | 1 | 1 | 1 | 1 | 2 | 2 | 2 | 1 | 1 | 1 | 1 | 1 | 1 | 16
 | Data
 | 数据导出命令格式
 | Field | 起始字符 | 数据导出装置识别码 | 版本号 | 地址 | 类型 | 命令长度 | 命令数据 | CRC16 | 停止符
 | Bytes | 1 | 8 | 1 | 1 | 1 | 1 | 1 | 2 | 1
 | Data | 0X40 |  | 2 | 0x7E | 0x7F |  |  |  | 0x40
 |  |  |  |  | 命令定义 | 命令说明 | 命令长度 | 命令数据
 |  |  |  |  | 数据读 | 读控制器运行数据存储单元1条数据 | 1 | 1
 |  |  |  |  | 数据重发 | 接收信息错误、超时，要求数据重新发送 | 1 | 2
 |  |  |  |  | 数据读首火警信息 | 读控制器运行数据存储单元1条首火警数据 | 1 | 3
 |  |  |  |  | 数据读火警信息 | 读控制器运行数据存储单元1条火警数据 | 1 | 4

Sheet: 数据导出命令定义
命令定义 | 命令说明 | 命令长度 | 命令数据
数据读 | 读控制器运行数据存储单元1条数据 | 1 | 1
数据重发 | 接收信息错误、超时，要求数据重新发送 | 1 | 2
数据读首火警信息 | 读控制器运行数据存储单元1条首火警数据 | 1 | 3
数据读火警信息 | 读控制器运行数据存储单元1条火警数据 | 1 | 4

Sheet: 事件代码
状态代码 | 说明
0 | 预留
1 | 正常
2 | 首火警
3 | 火警
4 | 电气火灾报警
5 | 可燃气体低限报警
6 | 可燃气体高限报警
7 | 可燃气体超量程报警
8 | 电气火灾预警
9～19 | 预留
20 | 启动
21 | 自动启动
22 | 手动启动
23 | 现场急启
24 | 气体灭火开始延时
25 | 气体喷洒
26 | 反馈
27 | 喷洒反馈
28 | 反馈撤销
29 | 停止
30 | 现场急停
31～39 | 预留
40 | 应急
41 | 月检
42 | 年检
43 | 标志灯具改变方向
44 | 电梯迫降
45 | 卷帘半降
46 | 卷帘全降
47 | 呼叫
48 | 通话
49 | 消防设备电源失电
50 | 消防设备电源欠压
51 | 消防设备电源过压
52 | 消防设备电源过载
53 | 消防设备电源缺相
54 | 消防设备电源错相
55 | 消防水箱（池）水位低
56 | 消防电梯停用
57～69 | 预留
70 | 监管
71 | 监管解除
72 | 屏蔽
73 | 屏蔽解除
74～79 | 预留
80 | 故障
81 | 通讯故障
82 | 主电故障
83 | 备电故障
84 | 充电故障
85 | 回路故障
86 | 部件故障
87 | 线路故障
88 | 接地故障
89 | 常闭防火门打开
90 | 常开防火门关闭
91～99 | 预留
100 | 故障恢复
101 | 通讯故障恢复
102 | 主电故障恢复
103 | 备电故障恢复
104 | 充电故障恢复
105 | 回路故障恢复
106 | 部件故障恢复
107 | 线路故障恢复
108 | 接地故障恢复
109 | 常闭防火门恢复关闭状态
110 | 常开防火门恢复开门状态
111～119 | 预留
120 | 开机
121 | 关机
122 | 复位
123 | 自检
124 | 自检失败
127 | 手动状态
128 | 自动状态
129 | 确认/消音
130～255 | 预留
256～65535 | 用户自定义

Sheet: 状态代码
位（Bit） | 说明
0 | 0 手动状态；1自动状态
1 | 0 主电工作；1备电工作
2 | 0 电源正常；1电源故障
3 | 0 无报警；1有报警
4 | 0 无启动；1有启动
5 | 0 无反馈；1有反馈
6 | 0 无监管；1有监管
7 | 0 无故障；1有故障
8 | 0 无屏蔽；1有屏蔽
9 | 0 无气体喷洒；1有气体喷洒
10 | 0 无应急；1有应急
11 | 预留
12 | 预留
13 | 预留
14 | 预留
15 | 预留

Sheet: 设备类型代码
类型代码 | 说明
0 | 预留
1 | 火灾报警控制器/火灾报警控制器（联动型）
2 | 消防联动控制器
3 | 消防控制室图形显示装置
4～9 | 预留
10 | 火灾显示盘
11 | 探测回路
12 | 控制回路
13 | 主电源
14 | 备用电源
15 | 充电电路
16 | 声光警报回路
17 | 运行数据存储单元
18～19 | 预留
20 | 火灾探测器
21 | 感烟火灾探测器
22 | 点型离子感烟火灾探测器
23 | 点型光电感烟火灾探测器
24 | 线型光束感烟火灾探测器
25 | 吸气式感烟火灾探测器
26～29 | 预留
30 | 感温火灾探测器
31 | 点型感温火灾探测器
32 | 线型感温火灾探测器
33 | 缆式线型火灾探测器
34 | 空气管式线型火灾探测器
35 | 线型光纤 感温火灾探测器
36～39 | 预留
40 | 火焰探测器
41 | 点型红外火焰探测器
42 | 点型紫外火焰探测器
43 | 点型复合式红外紫外火焰探测器
44～49 | 预留
50 | 多传感复合探测器
51 | 感光火灾探测器
52 | 图像型火灾探测器
53 | 点型一氧化碳火灾探测器
54～60 | 预留
61 | 手动火灾报警按钮
62 | 消火栓按钮
63 | 紧急启动按钮
64 | 紧急停止按钮
65～70 | 预留
71 | 模块
72 | 输入模块
73 | 输出模块
74 | 输入/输出模块
75 | 中继模块
76 | 短路隔离器
77～80 | 预留
81 | 火灾警报装置
82 | 火灾声光警报器
83 | 火灾声警报器
84 | 火灾光警报器
85 | 气体释放警报器
86 | 警铃
87～99 | 预留
100 | 可燃气体报警控制器
101 | 可燃气体探测器
102 | 点型可燃气体探测器
103 | 线型可燃气体探测器
104～109 | 预留
110 | 电气火灾监控设备
111 | 电气火灾监控探测器
112 | 剩余电流式电气火灾监控探测器
113 | 测温式电气火灾监控探测器
114 | 故障电弧探测装置
115～119 | 预留
120 | 应急照明控制器
121 | 消防应急标志灯具
122 | 消防应急照明灯具
123 | 消防应急灯具专用应急电源
124 | 应急照明分配电装置
125～129 | 预留
130 | 防火门监控器
131 | 常闭防火门
132 | 常开防火门
133 | 防火门电动闭门器
134 | 防火门电磁释放器
135 | 防火门门磁开关
136～139 | 预留
140 | 消防设备电源监控器
141 | 消防设备电源电压信号传感器
142 | 消防设备电源电流信号传感器
143 | 消防设备电源电压/电流信号传感器
144～149 | 预留
150 | 气体灭火控制器
151 | 泡沫灭火系统
152 | 干粉灭火系统
153 | 防烟排烟系统
154 | 防火卷帘控制器
155 | 挡烟垂壁控制装置
156 | 消防应急广播
157 | 消防电话主机
158 | 消防设备应急电源
159 | 传输设备
160 | 家用火灾安全系统控制中心监控设备
161 | 消防水位监视器
162 | 消防电梯
163 | 消防电气控制装置
164～179 | 预留
180 | 消防栓泵
181 | 水喷雾泵
182 | 细水雾泵
183 | 稳压泵
184 | 喷淋泵
185 | 雨淋泵
186 | 泡沫液泵
187 | 水流指示器
188 | 报警阀
189 | 压力开关
190 | 阀驱动装置
191 | 防火阀
192 | 70度防火阀
193 | 280度防火阀
194 | 通风空调
195 | 管网电磁阀
196 | 防烟排烟风机
197 | 排烟防火阀
198 | 常闭送风口
199 | 排烟口
200 | 消防水炮
201 | 电动门
202 | 排烟机
203 | 送风机
204 | 电磁阀
205 | 照明配电
206 | 动力配电
207 | 空压机
208 | 阀门
209 | 配电箱
210～255 | 预留
256～65535 | 用户自定义

Sheet: 参量类型定义
类型代码 | 说明 | 单位量值 | 数据类型
0 | 预留 | 预留 | 预留
1 | 高度 | 0.01m | int
2 | 温度 | 0.1℃ | int
3 | 压力 | 0.1MPa | int
4 | 压力 | 0.1kPa | int
5 | 气体浓度 | 0.1％LEL | uint
6 | 气体浓度 | 0.1×10-6体积比 | uint
7 | 气体浓度 | 0.1％体积比 | uint
8 | 气体浓度 | 1000×10-6体积比 | uint
9 | 气体浓度 | 1mg/ m3 | uint
10 | 时间 | 1s | int
11 | 电压 | 0.1V | int
12 | 电流 | 0.1A | int
13 | 流量 | 0.1L/s | uint
14 | 风量 | 0.1m3/min | uint
15 | 风速 | 0.1m/s | uint
16 | 剩余电流 | 1mA | uint
17 | 烟参量 | 自定义 | uint
18～127 | 预留 | 预留 | 预留
128～255 | 用户自定义 | 用户自定义 | 用户自定义

Sheet: 容量计算
消防联动设备数目 | 2000 | 个
火灾报警触发器数目 | 4000 | 个
1条记录字节数 | 18 | Bytes
需要的容量 | 756000 | Bytes
 | 738.28125 | K
 | 0.7209777832 | M

Sheet: 消防系统设备控制总线通信协议
消防控制室图形显示装 置的通信方式（RS485/CAN/RJ45）
1. 消防系统设备控制总线中采用请求/应答模式的应用层报文传输协议， 它在连接至不同类型总线或网络的设备之间通过一组功能代码提供规定的服务。 2. 火灾自动报警系统设备与消防控制室图形显示装置应采用一对一的主从通信方式， 火灾自动报警系统设备为主机，消防控制室图形显示装置为从机
消防联动设备的通信方式(CAN/RS485)
1.火灾报警控制器（联动型）应为主控节点，负责接收网络内各子系统节点的上传信息，下发控制和管理信息.火灾报警控制器（联动型）的地址编号应为1，消防联动控制设备的地址编号应为2～63 2.消防联动控制设备的通信链路中，任一点断路或短路时，火灾报警控制器（联动型）与消防联动控制设备应能正常通信
消防系统设备控制总线FECbus（fire system equipment control bus） 火灾自动报警系统中，火灾报警控制器（联动型）通过消防联动通信模块与消火栓系统、自动灭火系统、防排烟系统、防火卷帘监控系统、防火门监控系统、消防应急广播、消防应急照明和疏散指示系统等消防联动控制设备之间传送信息的通信线路。

Sheet: 协议报文
帧类型名称 | 报文头 |  |  |  |  |  |  | 报文
 | 帧类型 | 目标地址 | 优先级 | 源地址 | 报文编号 | 分组编号 | 数据长度 | 数据0 | 数据1 | 数据2 | 数据3 | 数据4 | 数据5 | 数据6 | 数据7 | 校验0 | 校验1
请求帧 | 00h | XXh | 0Xh | XXh | XXh | 00h | 0Xh | 功能码 | 数据 | 数据 | 数据 | 数据 | 数据 | 数据 | 数据 | CRC0 | CRC1
应答帧 | 01h | XXh | 03h | XXh | XXh | XXh | 0Xh | 数据 | 数据 | 数据 | 数据 | 数据 | 数据 | 数据 | 数据 | CRC0 | CRC1
状态应答帧 | 01h | XXh | 03h | XXh | XXh | 00h | 02h | 0Fh | 应答码 | —— | —— | —— | —— | —— | —— | CRC0 | CRC1
设置数据帧与应答：火灾报警控制器（联动型）发送给消防联动控制设备的设置数据帧
 |  |  | 设置数据帧
功能码数值 | 报文名称 | 报文头 |  |  |  |  |  |  | 报文
 |  | 帧类型 | 目标地址 | 优先级 | 源地址 | 报文编号 | 分组编号 | 数据长度 | 数据0 | 数据1 | 数据2 | 数据3 | 数据4 | 数据5 | 数据6 | 数据7 | 校验0 | 校验1
0 | 同步系统节拍 | 00H | XXH | 00H | 01H | 00H | 00H | 01H | 00H | —— | —— | —— | —— | —— | —— | —— | CRC0 | CRC1
1 | 系统复位 | 00H | XXH | 01H | 01H | XXH | 00H | 02H | 01H | 控制器编号 | —— | —— | —— | —— | —— | —— | CRC0 | CRC1
2 | 系统消音 | 00H | XXH | 01H | 01H | XXH | 00H | 02H | 02H | 控制器编号 | —— | —— | —— | —— | —— | —— | CRC0 | CRC1
3 | 系统自检 | 00H | XXH | 03H | 01H | XXH | 00H | 02H | 03H | 控制器编号 | —— | —— | —— | —— | —— | —— | CRC0 | CRC1
4 | 广播时钟 | 00H | XXH | 03H | 01H | XXH | 00H | 08H | 04H | 控制器编号 | 年 | 月 | 日 | 时 | 分 | 秒 | CRC0 | CRC1
5 | 通告紧急事件 | 00H | XXH | 01H | 01H | XXH | 01H | 08H | 05H | 控制器编号 | 单元编号 | 设备编号 | 通道编号 | 设备类型代码 | 设备类型代码 | 事件代码 | CRC0 | CRC1
 |  |  |  |  |  |  |  |  |  |  |  |  |  | 0 | 1 | 0
 |  | 00H | XXH | 01H | 01H | XXH | 02H | 08H | 事件代码 | 状态代码0 | 状态代码1 | 年 | 月 | 日 | 时 | 分 | CRC0 | CRC1
 |  |  |  |  |  |  |  |  | 1
 |  | 00H | XXH | 01H | 01H | XXH | 03H | 01H | 秒 | —— | —— | —— | —— | —— | —— | —— | CRC0 | CRC1
 |  | 00H | XXH | 01H | 01H | XXH | 00H | 02H | 0FH | 00H | —— | —— | —— | —— | —— | —— | CRC0 | CRC1 | 结束帧的报文编号是否与发送报文一致？
6 | 通告一般事件 | 00H | XXH | 03H | 01H | XXH | 01H | 08H | 06H | 控制器编号 | 单元编号 | 设备编号 | 通道编号 | 设备类型代码 | 设备类型代码 | 事件代码 | CRC0 | CRC1
 |  |  |  |  |  |  |  |  |  |  |  |  |  | 0 | 1 | 0
 |  | 00H | XXH | 03H | 01H | XXH | 02H | 08H | 事件代码 | 状态代码0 | 状态代码1 | 年 | 月 | 日 | 时 | 分 | CRC0 | CRC1
 |  |  |  |  |  |  |  |  | 1
 |  | 00H | XXH | 03H | 01H | XXH | 03H | 01H | 秒 | —— | —— | —— | —— | —— | —— | —— | CRC0 | CRC1
 |  | 00H | XXH | 03H | 01H | XXH | 00H | 02H | 0FH | 00H | —— | —— | —— | —— | —— | —— | CRC0 | CRC1
注1：广播类目标地址为00H时，表示全系统广播，如果不为00H，表示对目标地址广播。
注2：设备类型代码可查表C.15
注3：控制器编号为00H时，表示对目标地址的所有控制器广播。
注4：紧急事件包括：火警下传、启动命令、停止命令、更改控制方式；一般事件包括：故障、屏蔽等事件。事件代码可查表C.16。
注5：状态代码可查表C.17
 |  |  |  |  |  |  |  |  |  |  |  |  | 结束帧的报文编号是否与发送报文一致？
 |  |  | 设置应答数据帧
功能码数值 | 报文名称 | 报文头 |  |  |  |  |  |  | 报文
 |  | 帧类型 | 目标地址 | 优先级 | 源地址 | 报文编号 | 分组编号 | 数据长度 | 数据0 | 数据1 | 数据2 | 数据3 | 数据4 | 数据5 | 数据6 | 数据7 | 校验0 | 校验1
0 | 同步系统节拍应答 | 01H | 01H | 03H | XXH | XXH | 00H | 01H | 00H | —— | —— | —— | —— | —— | —— | —— | CRC0 | CRC1
1 | 系统复位应答 | 01H | 01H | 03H | XXH | XXH | 00H | 01H | 01H | —— | —— | —— | —— | —— | —— | —— | CRC0 | CRC1
2 | 系统消音应答 | 01H | 01H | 03H | XXH | XXH | 00H | 01H | 02H | —— | —— | —— | —— | —— | —— | —— | CRC0 | CRC1
3 | 系统自检应答 | 01H | 01H | 03H | XXH | XXH | 00H | 01H | 03H | —— | —— | —— | —— | —— | —— | —— | CRC0 | CRC1
4 | 广播时钟 | 01H | 01H | 03H | XXH | XXH | 00H | 01H | 04H | —— | —— | —— | —— | —— | —— | —— | CRC0 | CRC1
 | 应答
5 | 通告紧急事件应答 | 01H | 01H | 03H | XXH | XXH | 00H | 01H | 05H | —— | —— | —— | —— | —— | —— | —— | CRC0 | CRC1
6 | 通告一般事件应答 | 01H | 01H | 03H | XXH | XXH | 00H | 01H | 06H | —— | —— | —— | —— | —— | —— | —— | CRC0 | CRC1
15 | 状态应答 | 01H | 01H | 03H | XXH | XXH | 00H | 02H | 0FH | 状态应答码 | —— | —— | —— | —— | —— | —— | CRC0 | CRC1
注：状态应答码： 1-CRC校验错；2-无效服务请求；3-单元故障；4-系统忙；5-未识别命令；6-地址不存在；7-参数错误。
 |  |  |  |  |  |  |  |  |  |  | 应答帧的报文编号是否与发送报文一致？ 应答只针对报文，而不是针对某一帧数据？
通告数据帧与应答：消防联动控制设备发送给火灾报警控制器（联动型）的通告数据帧
 |  |  | 通告数据帧
功能码数值 | 报文名称 | 报文头 |  |  |  |  |  |  | 报文
 |  | 帧类型 | 目标地址 | 优先级 | 源地址 | 报文编号 | 分组编号 | 数据长度 | 数据0 | 数据1 | 数据2 | 数据3 | 数据4 | 数据5 | 数据6 | 数据7 | 校验0 | 校验1
17 | 通告紧急事件 | 00H | 01H | 01H | XXH | XXH | 01H | 08H | 11H | 控制器编号 | 单元编号 | 设备编号 | 通道编号 | 设备类型代码0 | 设备类型代码1 | 事件代码0 | CRC0 | CRC1
 |  | 00H | 01H | 01H | XXH | XXH | 02H | 08H | 事件代码1 | 状态代码0 | 状态代码1 | 年 | 月 | 日 | 时 | 分 | CRC0 | CRC1
 |  | 00H | 01H | 01H | XXH | XXH | 03H | 01H | 秒 | —— | —— | —— | —— | —— | —— | —— | CRC0 | CRC1
 |  | 00H | 01H | 01H | XXH | XXH | 00H | 02H | 0FH | 00H | —— | —— | —— | —— | —— | —— | CRC0 | CRC1
18 | 通告一般事件 | 00H | 01H | 03H | XXH | XXH | 01H | 07H | 12H | 控制器编号 | 单元编号 | 设备编号 | 通道编号 | 设备类型代码0 | 设备类型代码1 | 事件代码0 | CRC0 | CRC1
 |  | 00H | 01H | 03H | XXH | XXH | 02H | 08H | 事件代码1 | 状态代码0 | 状态代码 | 年 | 月 | 日 | 时 | 分 | CRC0 | CRC1
 |  |  |  |  |  |  |  |  |  |  | 1
 |  | 00H | 01H | 03H | XXH | XXH | 03H | 01H | 秒 | —— | —— | —— | —— | —— | —— | —— | CRC0 | CRC1
 |  | 00H | 01H | 03H | XXH | XXH | 00H | 02H | 0FH | 00H | —— | —— | —— | —— | —— | —— | CRC0 | CRC1
19 | 通告心跳 | 00H | 01H | 03H | XXH | XXH | 00H | 01H | 13H | —— | —— | —— | —— | —— | —— | —— | CRC0 | CRC1
注1：设备类型代码可查表C.15
注2：紧急事件包括：火警通告、启动命令、停止命令、更改控制方式；一般事件包括：故障、屏蔽等事件。事件代码可查表C.16。
注3：状态代码可查表C.17
 |  |  | 通告应答数据帧
功能码数值 | 报文名称 | 报文头 |  |  |  |  |  |  | 报文
 |  | 帧类型 | 目标地址 | 优先级 | 源地址 | 报文编号 | 分组编号 | 数据长度 | 数据0 | 数据1 | 数据2 | 数据3 | 数据4 | 数据5 | 数据6 | 数据7 | 校验0 | 校验1
17 | 通告紧急事件应答 | 01H | XXH | 01H | 01H | XXH | 00H | 01H | 11H | —— | —— | —— | —— | —— | —— | —— | CRC0 | CRC1
18 | 通告一般事件应答 | 01H | XXH | 03H | 01H | XXH | 00H | 01H | 12H | —— | —— | —— | —— | —— | —— | —— | CRC0 | CRC1
15 | 状态应答 | 01H | XXH | 03H | 01H | XXH | 00H | 02H | 0FH | 状态应答码 | —— | —— | —— | —— | —— | —— | CRC0 | CRC1
注：状态应答码： 1-CRC校验错；2-无效服务请求；3-单元故障；4-系统忙；5-未识别命令；6-地址不存在；7-参数错误。
查询数据帧与应答：火灾报警控制器（联动型）发送给消防联动控制设备的查询数据帧
 |  |  | 查询数据帧
功能码数值 | 报文名称 | 报文头 |  |  |  |  |  |  | 报文
 |  | 帧类型 | 目标地址 | 优先级 | 源地址 | 报文编号 | 分组编号 | 数据长度 | 数据0 | 数据1 | 数据2 | 数据3 | 数据4 | 数据5 | 数据6 | 数据7 | 校验0 | 校验1
33 | 设备巡检 | 00H | XXH | 02H | 01H | XXH | 00H | 01H | 21H | —— | —— | —— | —— | —— | —— | —— | CRC0 | CRC1
34 | 查设备状态 | 00H | XXH | 02H | 01H | XXH | 00H | 01H | 22H | 控制器编号 | 单元编号 | 设备编号 | —— | —— | —— | —— | CRC0 | CRC1
 |  |  |  |  |  |  |  | /
 |  |  |  |  |  |  |  | 02H
 |  |  |  |  |  |  |  | /
 |  |  |  |  |  |  |  | 03H
 |  |  |  |  |  |  |  | /
 |  |  |  |  |  |  |  | 04H
35 | 查设备配置 | 00H | XXH | 02H | 01H | XXH | 00H | 01H | 23H | 控制器编号 | 单元编号 | 设备编号 | —— | —— | —— | —— | CRC0 | CRC1
 |  |  |  |  |  |  |  | /
 |  |  |  |  |  |  |  | 02H
 |  |  |  |  |  |  |  | /
 |  |  |  |  |  |  |  | 03H
 |  |  |  |  |  |  |  | /
 |  |  |  |  |  |  |  | 04H
36 | 查设备标识 | 00H | XXH | 02H | 01H | XXH | 00H | 01H | 24H | 控制器编号 | 单元编号 | 设备编号 | —— | —— | —— | —— | CRC0 | CRC1
 |  |  |  |  |  |  |  | /
 |  |  |  |  |  |  |  | 02H
 |  |  |  |  |  |  |  | /
 |  |  |  |  |  |  |  | 03H
 |  |  |  |  |  |  |  | /
 |  |  |  |  |  |  |  | 04H
37 | 查设备参量 | 00H | XXH | 02H | 01H | XXH | 00H | 05H | 25H | 控制器编号 | 单元编号 | 设备编号 | 通道编号 | —— | —— | —— | CRC0 | CRC1
38 | 查设备注释 | 00H | XXH | 02H | 01H | XXH | 00H | 04H | 26H | 控制器编号 | 单元编号 | 设备编号 | —— | —— | —— | —— | CRC0 | CRC1
39 | 查设备编程 | 00H | XXH | 02H | 01H | XXH | 00H | 04H | 27H | 控制器编号 | 单元编号 | 设备编号 | —— | —— | —— | —— | CRC0 | CRC1
40 | 查注册登记信息 | 00H | XXH | 02H | 01H | XXH | 00H | 03H | 28H | 控制器编号 | 单元编号 | —— | —— | —— | —— | —— | CRC0 | CRC1
41 | 查设备当前事件 | 00H | XXH | 02H | 01H | XXH | 00H | 02H | 29H | 控制器编号 | 事件代码 | —— | —— | —— | —— | —— | CRC0 | CRC1
42 | 查设备历史事件 | 00H | XXH | 02H | 01H | XXH | 00H | 05H | 2AH | 控制器编号 | 事件代码 | 起始年 | 起始月 | 起始日 | —— | —— | CRC0 | CRC1
43 | 停止查询设备事件 | 00H | XXH | 02H | 01H | XXH | 00H | 01H | 2BH | 控制器编号 | —— | —— | —— | —— | —— | —— | CRC0 | CRC1
44 | 查FECbus协议版本号 | 00H | XXH | 02H | 01H | XXH | 00H | 01H | 2CH | —— | —— | —— | —— | —— | —— | —— | CRC0 | CRC1
注1：查设备状态数据帧的长度为01H时，控制器编号、单元编号和设备编号为空，表示查询指定地址的设备的状态；数据长度为02H时，单元编号和设备编号为空，表示查询指定地址指定控制器的状态；数据长度为03H时，设备编号为空，表示查询指定地址指定控制器指定单元的状态；数据长度为04H时，表示指定地址指定控制器指定单元指定设备的状态。
注2：查设备配置数据帧的数据长度为01H时，控制器编号、单元编号和设备编号为空，表示查询指定地址连接的控制器数目；数据长度为02H时，单元编号和设备编号为空，表示查询指定地址指定控制器连接的单元的数目；数据长度为03H时，设备编号为空，表示查询指定地址指定控制器指定单元连接的设备的数目；数据长度为04H时，表示查询指定地址指定控制器指定单元指定设备的通道数目。
注3：查设备标识数据帧的长度为01H时，控制器编号、单元编号和设备编号为空，表示查询指定地址的设备的标识；数据长度为02H时，单元编号和设备编号为空，表示查询指定地址指定控制器的标识；数据长度为03H时，设备编号为空，表示查询指定地址指定控制器指定单元的标识；数据长度为04H时，表示指定地址指定控制器指定单元指定设备的标识。
注4：事件代码可查表C.16，事件代码为0时表示查询全部事件信息。
 |  |  | 单帧查询应答数据帧
功能码数值 | 报文名称 | 报文头 |  |  |  |  |  |  | 报文
 |  | 帧类型 | 目标地址 | 优先级 | 源地址 | 报文编号 | 分组编号 | 数据长度 | 数据0 | 数据1 | 数据2 | 数据3 | 数据4 | 数据5 | 数据6 | 数据7 | 校验0 | 校验1
33 | 设备巡检应答 | 01H | 01H | 03H | XXH | XXH | 00H | 01H | 21H | —— | —— | —— | —— | —— | —— | —— | CRC0 | CRC1
34 | 查设备状态应答 | 01H | 01H | 03H | XXH | XXH | 00H | 03H | 22H | 状态代码0 | 状态代码1 | —— | —— | —— | —— | —— | CRC0 | CRC1
35 | 查设备配置应答 | 01H | 01H | 03H | XXH | XXH | 00H | 03H | 23H | 配置代码0 | 配置代码1 | —— | —— | —— | —— | —— | CRC0 | CRC1
36 | 查设备标识应答 | 01H | 01H | 03H | XXH | XXH | 00H | 08H | 24H | 标识代码0 | 标识代码1 | 标识代码2 | 标识代码3 | 标识代码4 | 标识代码5 | 标识代码6 | CRC0 | CRC1
37 | 查设备参量应答 | 01H | 01H | 03H | XXH | XXH | 00H | 04H | 25H | 参量类型代码 | 参量数值0 | 参量数值1 | —— | —— | —— | —— | CRC0 | CRC1
43 | 停止查询设备事件应答 | 01H | 01H | 03H | XXH | XXH | 00H | 01H | 2BH | —— | —— | —— | —— | —— | —— | —— | CRC0 | CRC1
44 | 查FECbus协议版本号应答 | 01H | 01H | 03H | XXH | XXH | 00H | 03H | 2CH | 协议版本号0 | 协议版本号1 | —— | —— | —— | —— | —— | CRC0 | CRC1
15 | 状态应答 | 01H | 01H | 03H | XXH | XXH | 00H | 02H | 0FH | 状态应答码 | —— | —— | —— | —— | —— | —— | CRC0 | CRC1
注1：状态代码、配置代码、标识代码、参量数值按照低位字节到高位字节的顺序传送。
注2：状态代码可查表C.17，参量类型代码可查表C.18，标识代码由制造商规定。
注3：配置代码返回查询目标设备的数量。
注4：状态应答码： 1-CRC校验错；2-无效服务请求；3-单元故障；4-系统忙；5-未识别命令；6-地址不存在；7-参数错误。
 |  |  | 查询设备注释应答数据帧
功能码数值 | 报文名称 | 报文头 |  |  |  |  |  |  | 报文
 |  | 帧类型 | 目标地址 | 优先级 | 源地址 | 报文编号 | 分组编号 | 数据长度 | 数据0 | 数据1 | 数据2 | 数据3 | 数据4 | 数据5 | 数据6 | 数据7 | 校验0 | 校验1
38 | 查设备注释应答1 | 01H | 01H | 03H | XXH | XXH | 00H | 08H | 26H | 控制器编号 | 单元编号 | 设备编号 | 注释字节数 | X[0] | X[1] | X[2] | CRC0 | CRC1
 |  |  |  |  |  |  | /
 |  |  |  |  |  |  | 01H
 | 查设备注释应答2 | 01H | 01H | 03H | XXH | XXH | 02H | 08H | X[3] | X[4] | X[5] | X[6] | X[7] | X[8] | X[9] | X[10] | CRC0 | CRC1
 | … | … | … | … | … | … | … | 08H | … | … | … | … | … | … | … | … | CRC0 | CRC1
 | 查设备注释应答n | 01H | 01H | 03H | XXH | XXH | n | XXH | X[(n-2)*8+3] | X[(n-2)*8+4] | X[(n-2)*8+5] | … | … | … | … | … | CRC0 | CRC1
 | 分组报文结束 | 01H | 01H | 03H | XXH | XXH | 00H | 02H | 0FH | 00H | —— | —— | —— | —— | —— | —— | CRC0 | CRC1
15 | 状态应答 | 01H | 01H | 03H | XXH | XXH | XXH | 02H | 0FH | 状态应答码 | —— | —— | —— | —— | —— | —— | CRC0 | CRC1
注1：注释字节数不大于3时，应答数据帧为单帧报文，分组编号为00H，不发送分组报文结束帧；注释字节数大于3时，应答数据报文为多帧报文，分组编号从01H开始升序编号，查设备注释应答帧发送结束后，发送分组报文结束帧；注释采用Unicode编码。
注2：状态应答码： 1-CRC校验错；2-无效服务请求；3-单元故障；4-系统忙；5-未识别命令；6-地址不存在；7-参数错误。
 |  |  | 查设备编程应答数据帧
功能码数值 | 报文名称 | 报文头 |  |  |  |  |  |  | 报文
 |  | 帧类型 | 目标地址 | 优先级 | 源地址 | 报文编号 | 分组编号 | 数据长度 | 数据0 | 数据1 | 数据2 | 数据3 | 数据4 | 数据5 | 数据6 | 数据7 | 校验0 | 校验1
39 | 查设备编程应答1 | 01H | 01H | 03H | XXH | XXH | 00H | 08H | 27H | 控制器编号 | 单元编号 | 设备编号 | 编程字节数 | X[0] | X[1] | X[2] | CRC0 | CRC1
 |  |  |  |  |  |  | /
 |  |  |  |  |  |  | 01H
 | 查设备编程应答2 | 01H | 01H | 03H | XXH | XXH | 02H | 08H | X[3] | X[4] | X[5] | X[6] | X[7] | X[8] | X[9] | X[10] | CRC0 | CRC1
 | … | … | … | … | … | … | … | 08H | … | … | … | … | … | … | … | … | CRC0 | CRC1
 | 查设备编程应答n | 01H | 01H | 03H | XXH | XXH | n | XXH | X[(n-2)*8+3] | X[(n-2)*8+4] | X[(n-2)*8+5] | … | … | … | … | … | CRC0 | CRC1
 | 分组报文结束 | 01H | 01H | 03H | XXH | XXH | 00H | 02H | 0FH | 00H | —— | —— | —— | —— | —— | —— | CRC0 | CRC1
15 | 状态应答 | 01H | 01H | 03H | XXH | XXH | XXH | 02H | 0FH | 状态应答码 | —— | —— | —— | —— | —— | —— | CRC0 | CRC1
注1：编程字节数不大于3时，应答数据帧为单帧报文，分组编号为00H，不发送分组报文结束帧；编程字节数大于3时，应答数据报文为多帧报文，分组编号从01H开始升序编号，查设备编程应答帧发送结束后，发送分组报文结束帧。
注2：状态应答码： 1-CRC校验错；2-无效服务请求；3-单元故障；4-系统忙；5-未识别命令；6-地址不存在；7-参数错误。
 |  |  | 查设备注册信息应答数据帧
功能码数值 | 报文名称 | 报文头 |  |  |  |  |  |  | 报文
 |  | 帧类型 | 目标地址 | 优先级 | 源地址 | 报文编号 | 分组编号 | 数据长度 | 数据0 | 数据1 | 数据2 | 数据3 | 数据4 | 数据5 | 数据6 | 数据7 | 校验0 | 校验1
40 | 查设备注册信息应答1 | 01H | 01H | 03H | XXH | XXH | 00H | 08H | 28H | 控制器编号 | 单元编号 | 设备编号 | 注册字节数 | X[0] | X[1] | X[2] | CRC0 | CRC1
 |  |  |  |  |  |  | /
 |  |  |  |  |  |  | 01H
 | 查设备注册信息应答2 | 01H | 01H | 03H | XXH | XXH | 02H | 08H | X[3] | X[4] | X[5] | X[6] | X[7] | X[8] | X[9] | X[10] | CRC0 | CRC1
 | … | … | … | … | … | … | … | 08H | … | … | … | … | … | … | … | … | CRC0 | CRC1
 | 查设备注册信息应答n | 01H | 01H | 03H | XXH | XXH | n | XXH | X[(n-2)*8+3] | X[(n-2)*8+4] | X[(n-2)*8+5] | … | … | … | … | … | CRC0 | CRC1
 | 分组报文结束 | 01H | 01H | 03H | XXH | XXH | 00H | 02H | 0FH | 00H | —— | —— | —— | —— | —— | —— | CRC0 | CRC1
15 | 状态应答 | 01H | 01H | 03H | XXH | XXH | XXH | 02H | 0FH | 状态应答码 | —— | —— | —— | —— | —— | —— | CRC0 | CRC1
注1：注册字节数不大于3时，应答数据帧为单帧报文，分组编号为00H，不发送分组报文结束帧；注册字节数大于3时，应答数据报文为多帧报文，分组编号从01H开始升序编号，查设备注册应答帧发送结束后，发送分组报文结束帧。
注2：状态应答码： 1-CRC校验错；2-无效服务请求；3-单元故障；4-系统忙；5-未识别命令；6-地址不存在；7-参数错误。
 |  |  | 查设备当前事件应答数据帧
功能码数值 | 报文名称 | 报文头 |  |  |  |  |  |  | 报文
 |  | 帧类型 | 目标地址 | 优先级 | 源地址 | 报文编号 | 分组编号 | 数据长度 | 数据0 | 数据1 | 数据2 | 数据3 | 数据4 | 数据5 | 数据6 | 数据7 | 校验0 | 校验1
41 | 查设备当前事件应答1 | 01H | 01H | 03H | XXH | XXH | 01H | 08H | 29H | 控制器编号 | 单元编号 | 设备编号 | 通道编号 | 设备类型代码0 | 设备类型代码1 | 事件代码0 | CRC0 | CRC1
 | 查设备当前事件应答2 | 01H | 01H | 03H | XXH | XXH | 02H | 08H | 事件代码1 | 状态代码0 | 状态代码1 | 年 | 月 | 日 | 时 | 分 | CRC0 | CRC1
 | 查设备当前事件应答3 | 01H | 01H | 03H | XXH | XXH | 03H | 01H | 秒 | —— | —— | —— | —— | —— | —— | —— | CRC0 | CRC1
 | 全部事件发送结束 | 01H | 01H | 03H | XXH | XXH | 00H | 02H | 0FH | 00H | —— | —— | —— | —— | —— | —— | CRC0 | CRC1
15 | 状态应答 | 01H | 01H | 03H | XXH | XXH | XXH | 02H | 0FH | 状态应答码 | —— | —— | —— | —— | —— | —— | CRC0 | CRC1
注1：应答数据报文为多帧报文，查设备当前事件应答帧发送结束后，发送分组报文结束帧。
注2：设备类型代码可查表C.15
注3：状态应答码： 1-CRC校验错；2-无效服务请求；3-单元故障；4-系统忙；5-未识别命令；6-地址不存在；7-参数错误。
注4：事件发送时间的年值为事件发生的年份减2000。
 |  |  | 查设备历史事件应答数据帧
功能码数值 | 报文名称 | 报文头 |  |  |  |  |  |  | 报文
 |  | 帧类型 | 目标地址 | 优先级 | 源地址 | 报文编号 | 分组编号 | 数据长度 | 数据0 | 数据1 | 数据2 | 数据3 | 数据4 | 数据5 | 数据6 | 数据7 | 校验0 | 校验1
42 | 查设备历史事件应答1 | 01H | 01H | 03H | XXH | XXH | 01H | 08H | 2AH | 控制器编号 | 单元编号 | 设备编号 | 通道编号 | 设备类型代码0 | 设备类型代码1 | 事件代码0 | CRC0 | CRC1
 | 查设备历史事件应答2 | 01H | 01H | 03H | XXH | XXH | 02H | 08H | 事件代码1 | 状态代码0 | 状态代码1 | 年 | 月 | 日 | 时 | 分 | CRC0 | CRC1
 | 查设备历史事件应答3 | 01H | 01H | 03H | XXH | XXH | 03H | 01H | 秒 | —— | —— | —— | —— | —— | —— | —— | CRC0 | CRC1
 | 全部事件发送结束 | 01H | 01H | 03H | XXH | XXH | 00H | 02H | 0FH | 00H | —— | —— | —— | —— | —— | —— | CRC0 | CRC1
15 | 状态应答 | 01H | 01H | 03H | XXH | XXH | XXH | 02H | 0FH | 状态应答码 | —— | —— | —— | —— | —— | —— | CRC0 | CRC1
注1：应答数据报文为多帧报文，查设备历史事件应答帧发送结束后，发送分组报文结束帧。
注2：设备类型代码可查表C.15
注3：状态应答码： 1-CRC校验错；2-无效服务请求；3-单元故障；4-系统忙；5-未识别命令；6-地址不存在；7-参数错误。
注4：事件发送时间的年值为事件发生的年份减2000。

Sheet: 协议报文在串口上封装
FECbus | 帧头 | 报文头 |  |  |  |  |  |  | 报文 |  | 帧尾
数据格式 |  | 帧类型 | 目标地址 | 优先级(PA) | 源地址 | 报文编号 | 分组编号 | 数据长度 | 数据0～数据7 | 校验0～校验1
 |  | (FT) | (DA) |  | (SA) | (MN) | (TN) | (DLC)
串行链路总线数据格式 | 帧起始符 | 1 byte | 1 byte | 1 byte | 1 byte | 1 byte | 1 byte | 1 byte | 8 byte | 2 byte | 帧结束符
 | 0x7E |  |  |  |  |  |  |  |  |  | 0x7E
CAN总线帧格式
起始 | 仲裁场 |  |  |  |  | 控制场 |  |  | 数据场 | 校验场 | 应答场 | 结束
帧起始 | 11位标识符 | SRR | IDE | 18位标识符 | RTR | r1 | r0 | 数据长度 | 数据 | 校验 | 应答 | 帧结束
(SOF) | (ID28-ID18) |  |  | (ID17-ID0) |  |  |  | (DLC) | (DATA) | (CRC) | (ACK) | (END)
1bit | 11bit | 1bit | 1bit | 18bit | 1bit | 1bit | 1bit | 4bit | 8byte | 15bit | 2bit | 7bit
0 | 设定 | 1 | 1 | 设定 | 0 | 保留 | 保留 | 设定 | 设定 | 自动 | 0 | 1
FECbus协议在CAN总线中的封装
FECbus | 报文头 |  |  |  |  |  |  | 报文
数据格式 | 帧类型 | 目标地址 | 优先级(PA) | 源地址 | 报文编号 | 分组编号 | 数据长度 | 数据0～数据7 | 校验0～校验1
 | (FT) | (DA) |  | (SA) | (MN) | (TN) | (DLC)
CAN总线数据格式 | ID.28～ID.27 | ID.26～ID.21 | ID.20～ID.19 | ID.18～ID.13 | ID.12～ID.7 | ID.6～ID.0 | 数据长度 | 数据 | 校验
 |  |  |  |  |  |  | (DLC) | (DATA) | (CRC)
 | 仲裁场 |  |  |  |  |  | 控制场 | 数据场 | 校验场
 | （设定） |  |  |  |  |  | （设定） | （设定）

Sheet: 协议报文在CAN上封装
CAN总线帧格式
起始 | 仲裁场 |  |  |  |  | 控制场 |  |  | 数据场 | 校验场 | 应答场 | 结束
帧起始 | 11位标识符 | SRR | IDE | 18位标识符 | RTR | r1 | r0 | 数据长度 | 数据 | 校验 | 应答 | 帧结束
(SOF) | (ID28-ID18) |  |  | (ID17-ID0) |  |  |  | (DLC) | (DATA) | (CRC) | (ACK) | (END)
1bit | 11bit | 1bit | 1bit | 18bit | 1bit | 1bit | 1bit | 4bit | 8byte | 15bit | 2bit | 7bit
0 | 设定 | 1 | 1 | 设定 | 0 | 保留 | 保留 | 设定 | 设定 | 自动 | 0 | 1
FECbus协议在CAN总线中的封装
FECbus | 报文头 |  |  |  |  |  |  | 报文
数据格式 | 帧类型 | 目标地址 | 优先级(PA) | 源地址 | 报文编号 | 分组编号 | 数据长度 | 数据0～数据7 | 校验0～校验1
 | (FT) | (DA) |  | (SA) | (MN) | (TN) | (DLC)
CAN总线数据格式 | ID.28～ID.27 | ID.26～ID.21 | ID.20～ID.19 | ID.18～ID.13 | ID.12～ID.7 | ID.6～ID.0 | 数据长度 | 数据 | 校验
 |  |  |  |  |  |  | (DLC) | (DATA) | (CRC)
 | 仲裁场 |  |  |  |  |  | 控制场 | 数据场 | 校验场
 | （设定） |  |  |  |  |  | （设定） | （设定）

Sheet: 功能码
功能码数值 | 十六进制数值 | 数据格式 | 功能说明 | 通信 | 应答
0 | 00H | 功能码 | 同步系统节拍 | 广播 | 有
1 | 01H | 功能码+编号（控制器编号） | 系统复位 | 广播/单播 | 有
2 | 02H | 功能码+编号（控制器编号） | 系统消音 | 广播/单播 | 有
3 | 03H | 功能码+编号（控制器编号） | 系统自检 | 广播/单播 | 有
4 | 04H | 功能码+编号（控制器编号）+时间（年+月+日+时+分+秒） | 广播时钟 | 广播/单播 | 有
5 | 05H | 功能码+编号（控制器编号+单元编号+设备编号+通道编号）+设备类型代码+事件代码+状态代码+时间（年+月+日+时+分+秒） | 火灾报警控制器（联动型）向消防联动控制设备通告紧急事件 | 广播/单播 | 有
6 | 06H | 功能码+编号（控制器编号+单元编号+设备编号+通道编号）+设备类型代码+事件代码+状态代码+时间（年+月+日+时+分+秒） | 火灾报警控制器（联动型）向消防联动控制设备通告一般事件 | 广播/单播 | 有
7～14 | 07H～0EH | 自定义 | 自定义 | 自定义 | 自定义
15 | 0FH | 功能码+状态应答码 | 反馈接收到请求的异常状态信息或结束帧标志 | 广播/单播 | ——
16 | 10H | 保留 | 保留 | 保留 | 保留
17 | 11H | 功能码+编号（控制器编号+单元编号+设备编号+通道编号）+设备类型代码+事件代码+状态代码+时间（年+月+日+时+分+秒） | 消防联动控制设备向火灾报警控制器（联动型）通告紧急事件 | 单播 | 有
18 | 12H | 功能码+编号（控制器编号+单元编号+设备编号+通道编号）+设备类型代码+事件代码+状态代码+时间（年+月+日+时+分+秒） | 消防联动控制设备向火灾报警控制器（联动型）通告一般事件 | 单播 | 有
19 | 13H | 功能码 | 消防联动控制设备向火灾报警控制器（联动型）通告心跳/巡检信息 | 单播 | 有
20～31 | 14H～1FH | 自定义 | 自定义 | 自定义 | 自定义
32 | 20H | 保留 | 保留 | 保留 | 保留
33 | 21H | 功能码+编号（控制器编号） | 火灾报警控制器巡检消防联动控制设备的连接状态 | 广播/单播 | 有
34 | 22H | 功能码+编号（控制器编号+单元编号+设备编号） | 查设备状态 | 单播 | 有
35 | 23H | 功能码+编号（控制器编号+单元编号+设备编号） | 查设备配置 | 单播 | 有
36 | 24H | 功能码+编号（控制器编号+单元编号+设备编号） | 查设备标识 | 单播 | 有
37 | 25H | 功能码+编号（控制器编号+单元编号+设备编号+通道编号） | 查设备参量 | 单播 | 有
38 | 26H | 功能码+编号（控制器编号+单元编号+设备编号） | 查设备注释 | 单播 | 有
39 | 27H | 功能码+编号（控制器编号+单元编号+设备编号） | 查设备编程 | 单播 | 有
40 | 28H | 功能码+编号（控制器编号+单元编号） | 查注册登记信息 | 单播 | 有
41 | 29H | 功能码+编号（控制器编号）+事件代码 | 查设备当前事件 | 单播 | 有
42 | 2AH | 功能码+编号（控制器编号）+事件代码+起始时间（年+月+日） | 查设备历史事件 | 单播 | 有
43 | 2BH | 功能码+编号（控制器编号） | 停止查询设备事件 | 单播 | 有
44 | 2CH | 功能码+编号（控制器编号） | 查FECbus协议版本号 | 单播 | 有
45～127 | 2DH～7FH | 自定义 | 自定义 | 自定义 | 自定义
128～255 | 80H～FFH | 保留 | 保留 | 保留 | 保留
注1：多字节代码，低字节在前，高字节在后。
注2：编号由控制器编号、单元编号、设备编号、通道编号组成。控制器编号为00H时，表示对目标地址的所有控制器广播；单元编号为00H时，表示对目标地址目标控制器的所有单元广播；设备编号为00H时，表示对目标地址目标控制器目标单元的所有设备广播；通道编号为00H时，表示对目标地址目标控制器目标单元目标设备的所有通道广播。
注3：紧急事件包括：火警通告、启动请求、停止请求、更改控制方式；一般事件包括：故障、屏蔽等事件。事件代码可查表C.16。
注4：状态代码可查表C.17
注5：状态应答码：0-分组报文结束；1-CRC校验错；2-无效服务请求；3-单元故障；4-系统忙；5-未识别命令；6-地址不存在；7-参数错误。
