acssca/Oxygen/Hardware/Main Board/V1.0/PTW3300SP_MB_V1.0.pdf

5

4

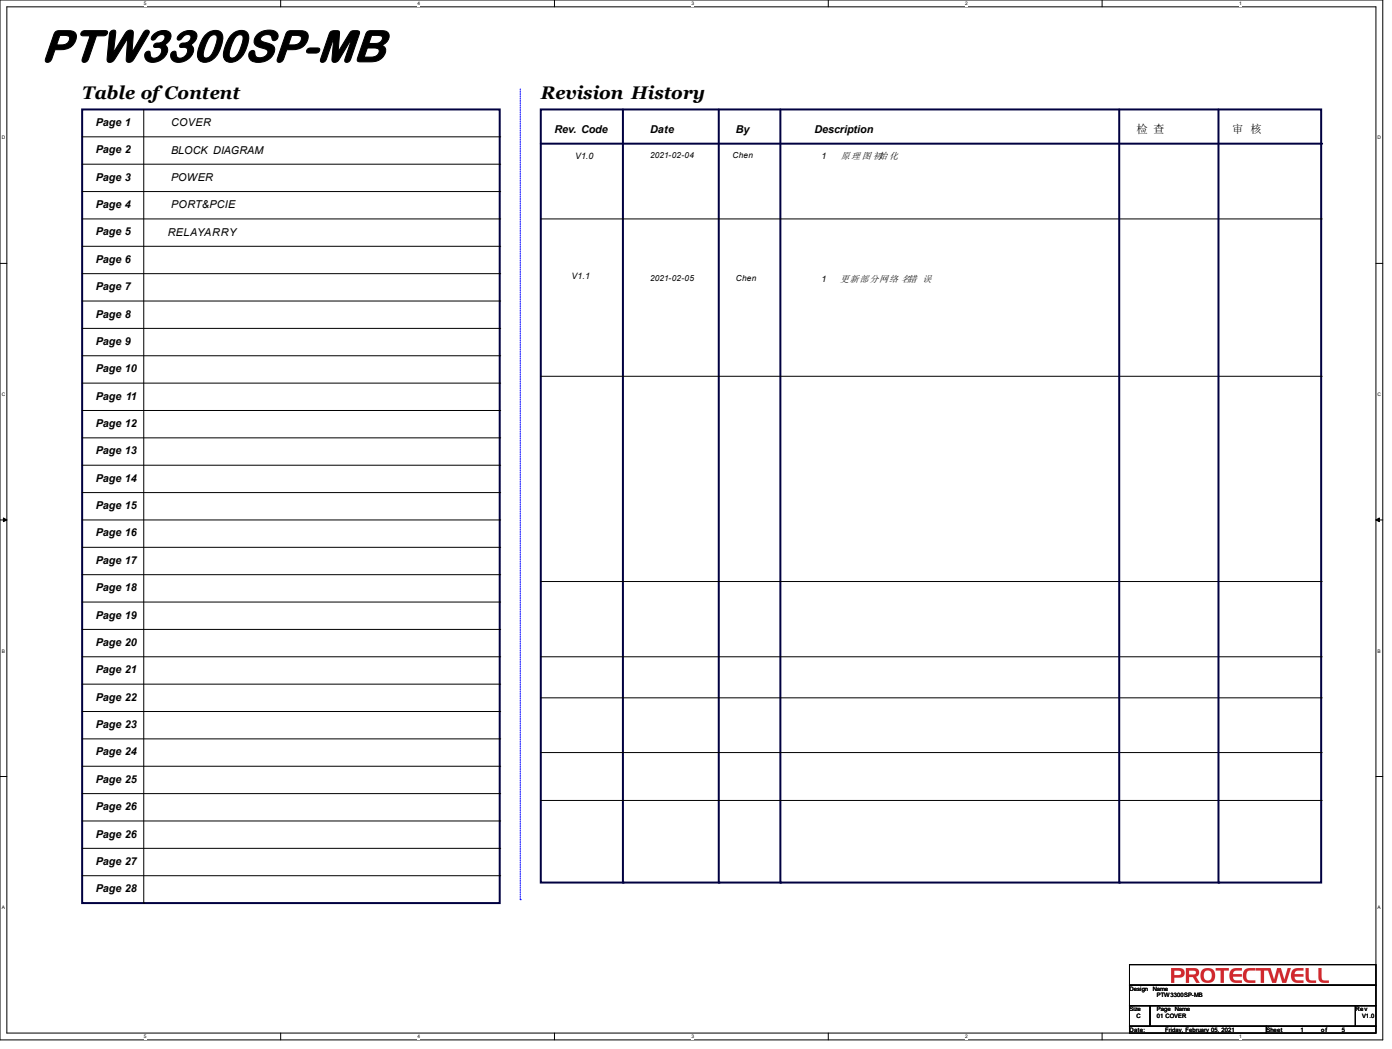
[picture p25: page 1]
PORT&PCIE; RELAYARRY; COVER; BLOCK DIAGRAM; Page 1; Page 2; Page 3; Page 4; Page 5; Page 6; Page 7; Page 8; Page 9; Page 10; Page 11; Page 12; Page 13; Page 14; Page 15; Page 16; Page 17; Page 18; Page 19; Page 20; Page 21; Revision History; Rev. Code; Date; Description By; PTW3300SP-MB; Page 22; Page 23; Page 24; Page 25; Page 26; Page 27; Page 28; POWER; Chen; 更新部分网络 名错 误; Design Name; Size; Page Name; Date:; Sheet; o f 01 COVER; V1.0 PTW3300SP-MB C; Friday, February 05, 2021

Table of Content

C C

# 继电器矩阵

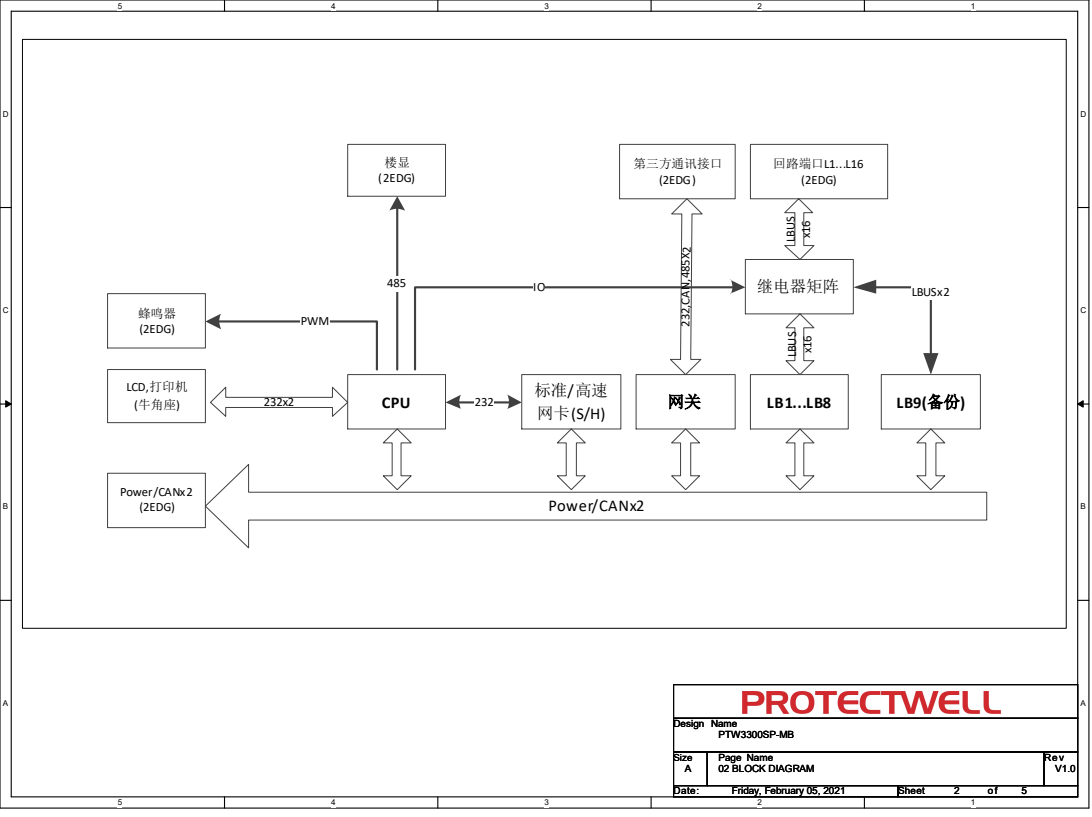
[picture p26: page 2]
CPU; LBUSx2 IO; 回路端口L1...L16 (2EDG); 楼显 (2EDG); 第三方通讯接口 (2EDG); Power/CANx2; 232 LBUS x16; LBUS x16; Power/CANx2 (2EDG); LCD,打印机; (牛角座); 蜂鸣器; (2EDG); PWM; Design Name; Size; Page Name; Rev; Date:; Sheet; o f 02 BLOCK DIAGRAM; V1.0 PTW3300SP-MB; Friday, February 05, 2021

C C

# EN>1.2V

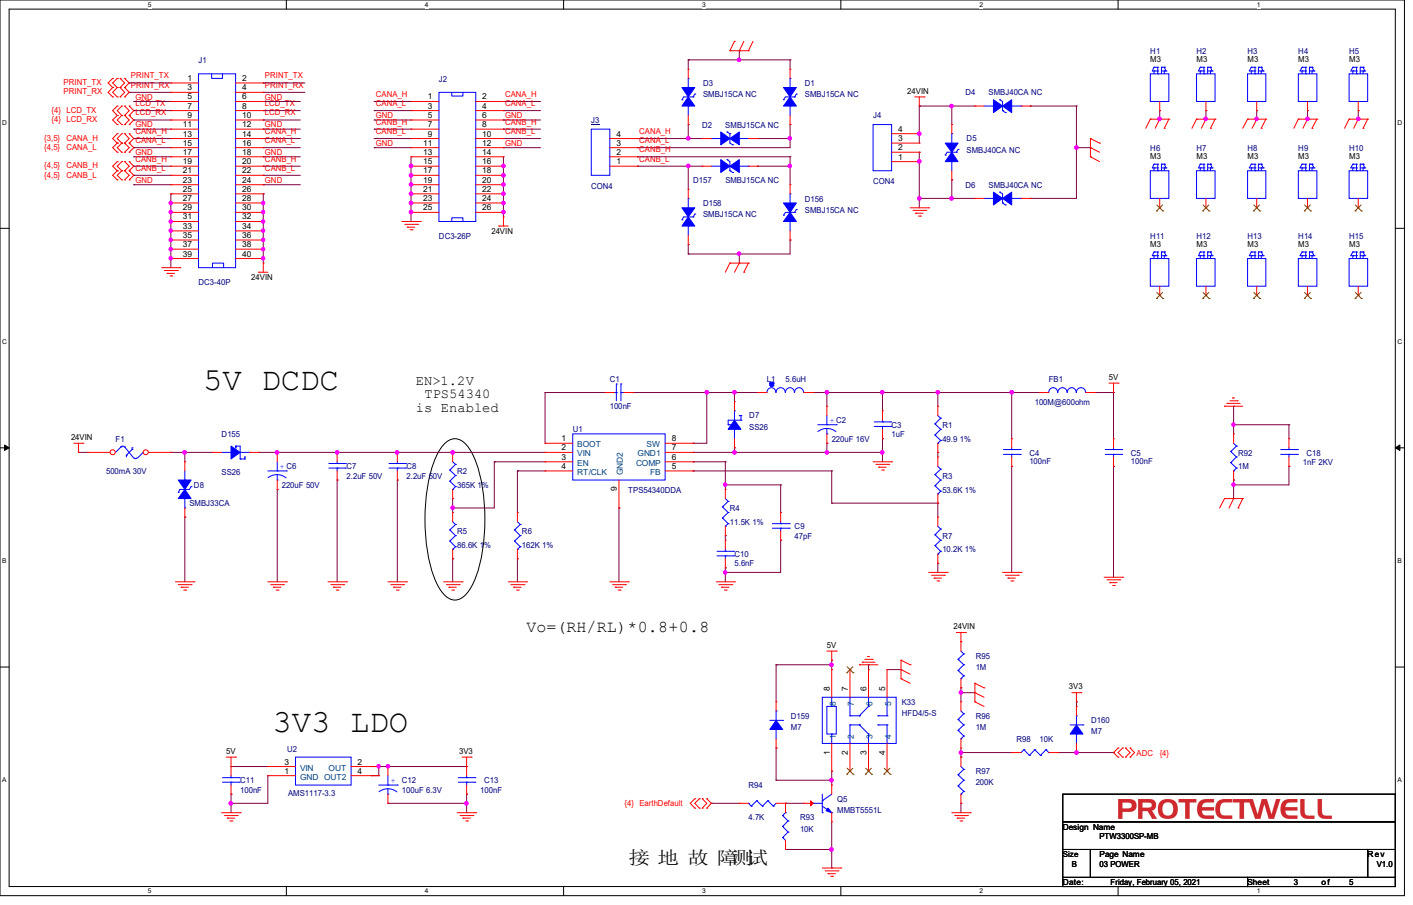
[picture p27: page 3]

# CPU1

LB1

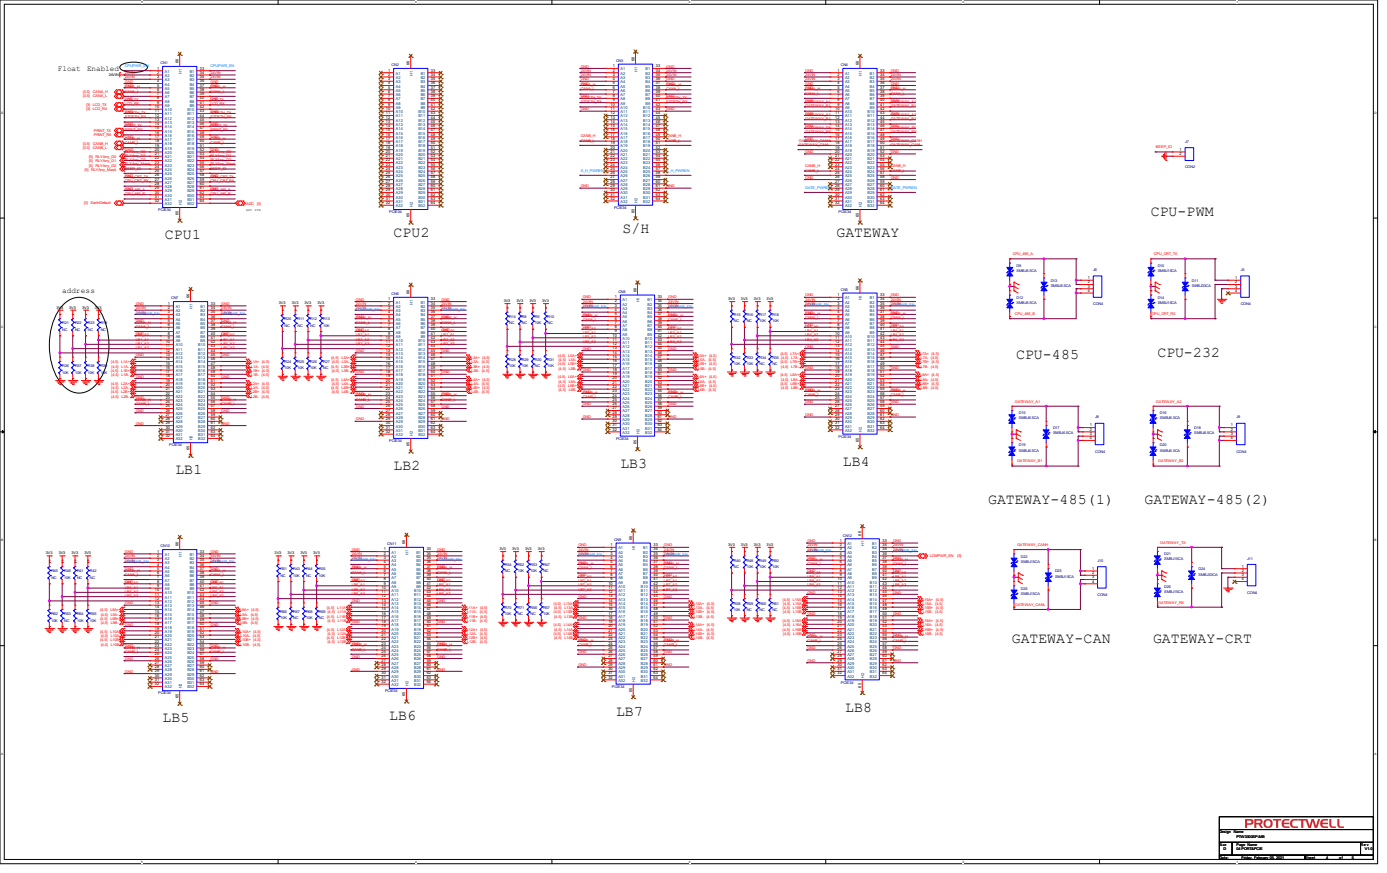
[picture p28: page 4]

CPU_CRT_TX CPU_CRT_RX GND GND RLYArry_D0 RLYArry_D1 RLYArry_D2 RLYArry_Mask GND GND

LB7_A3 GND GND GND GND GND
24VIN
24VIN LCMPWR_EN GND CANA_H

LB1 | LB2 | LB3
LB4 | LB6 LB5

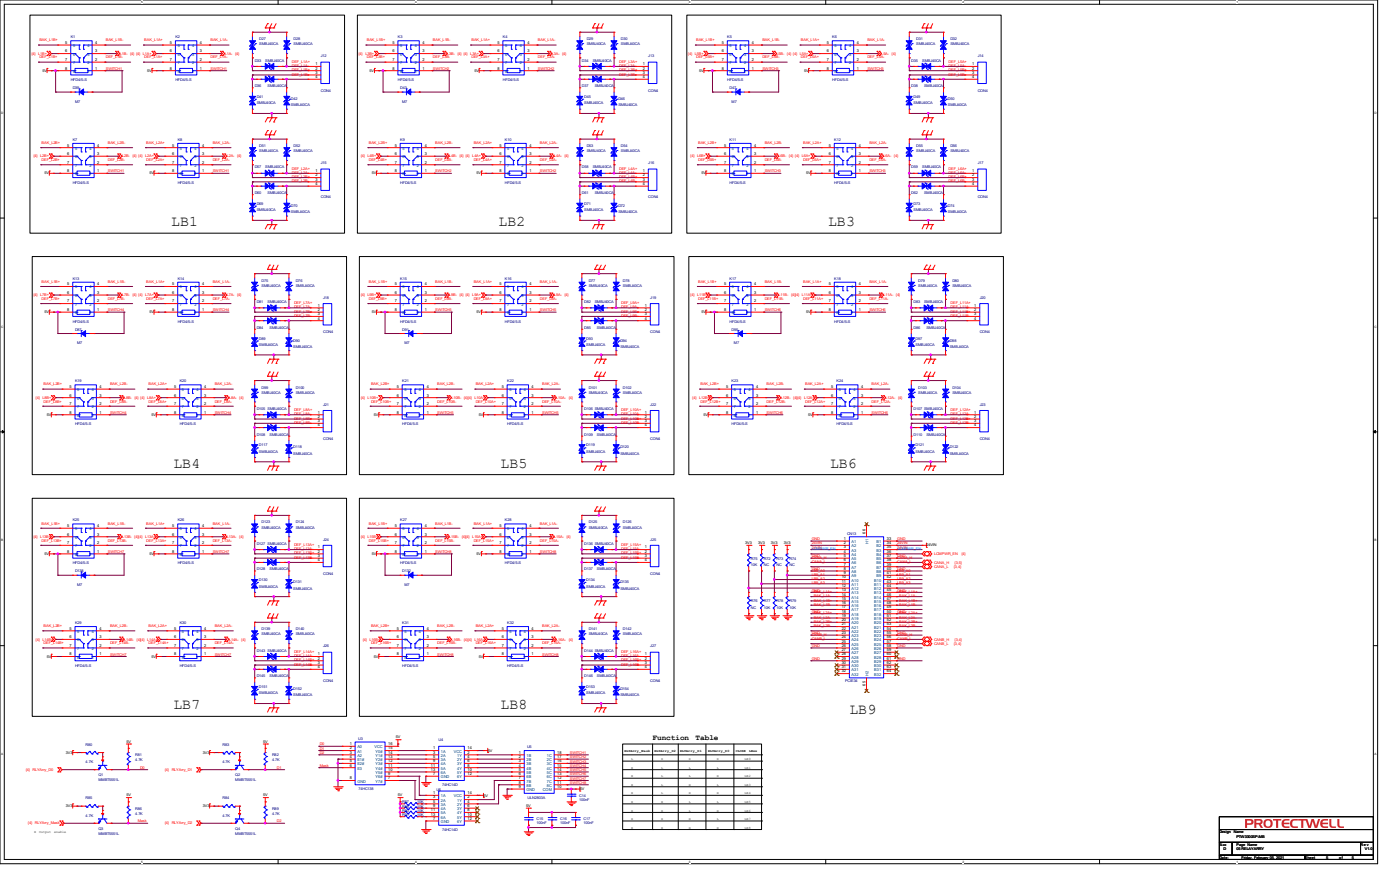
[picture p29: page 5]
