acssca/Oxygen/Mechanical/面板/新主机设计3.0版本03-18-03.pdf

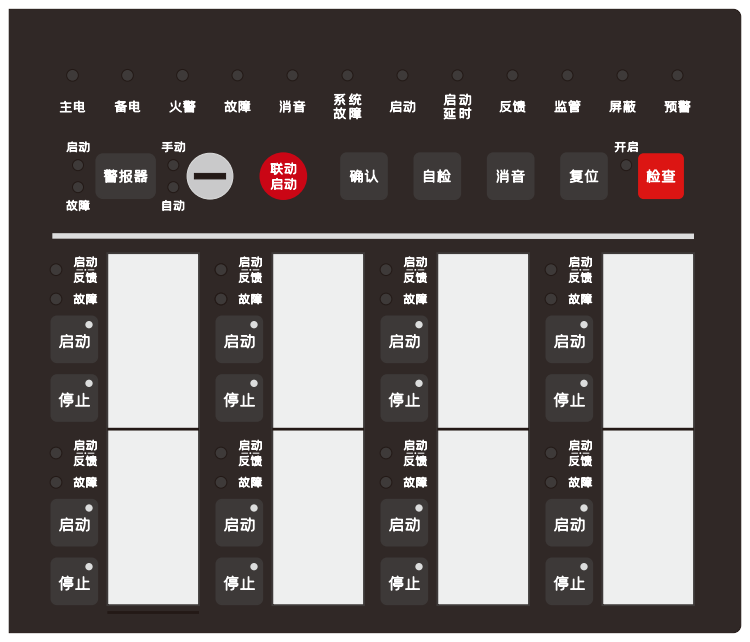
[picture p30: page 1]
警报器

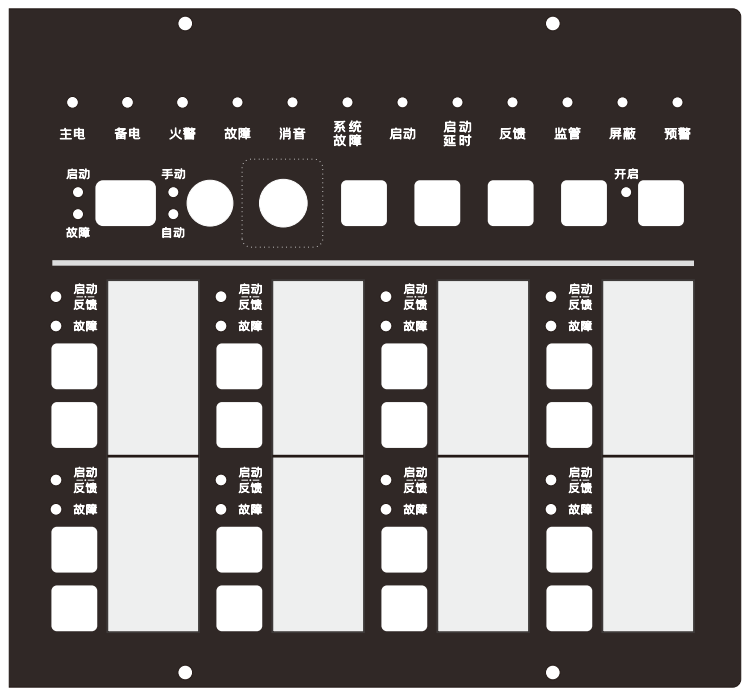
[picture p31: page 2]
