acssca/Oxygen/Mechanical/面板/新主机设计3.0版本03-18-02.pdf

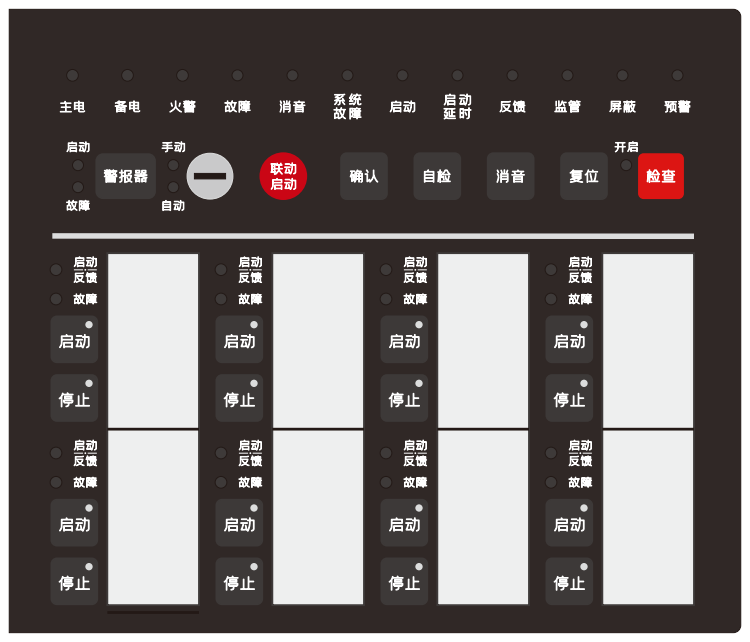
[picture p32: page 1]
警报器

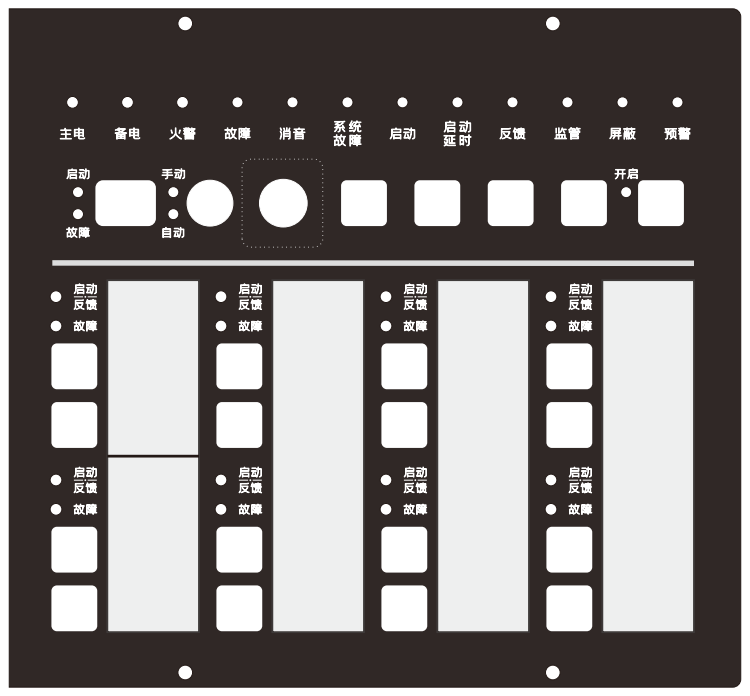
[picture p33: page 2]
