acssca/Oxygen/Mechanical/面板/新主机设计3.0版本03-18-01.pdf

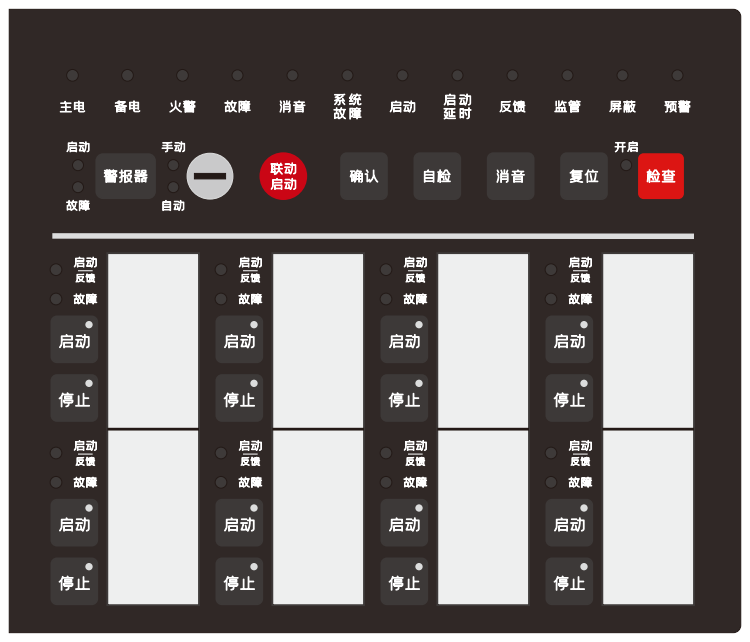
[picture p34: page 1]
警报器

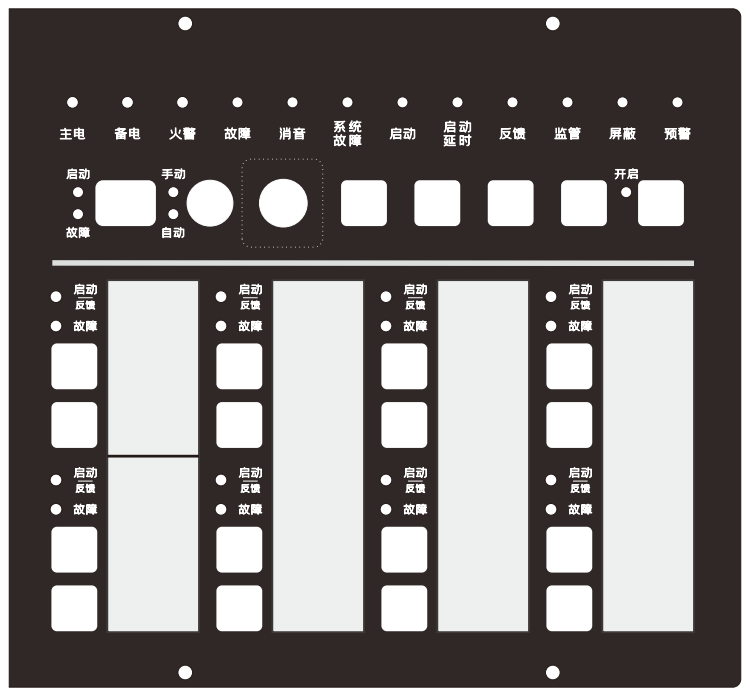
[picture p35: page 2]
