acssca/Oxygen/Mechanical/面板/新主机-PC面板-字魂175-版本2.0.pdf

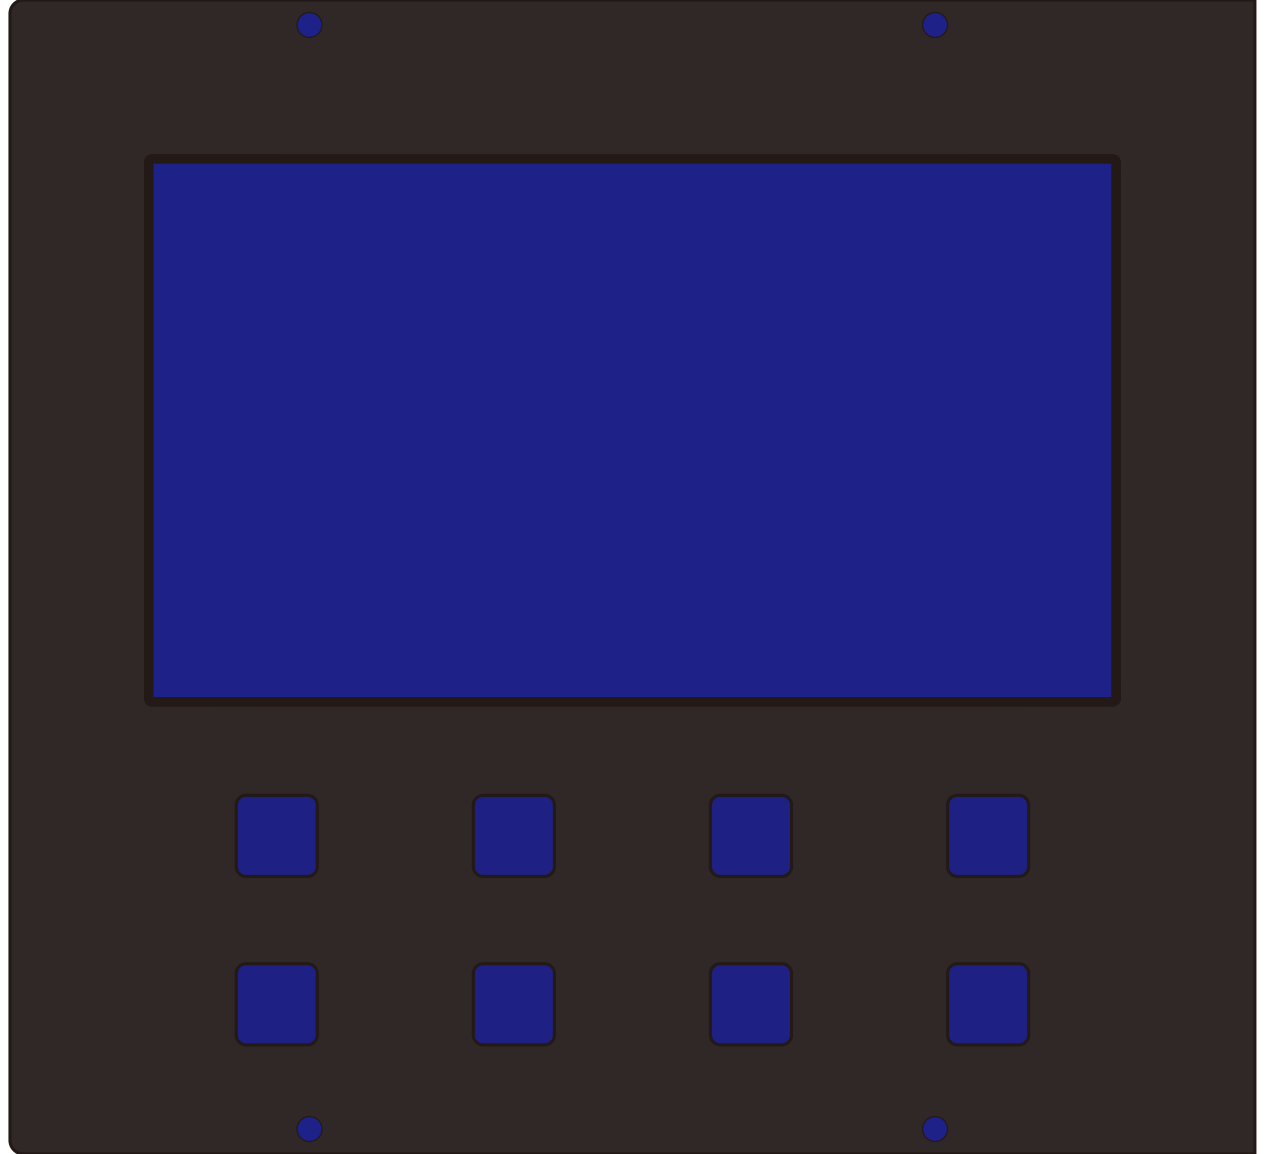
[picture p36: page 1]

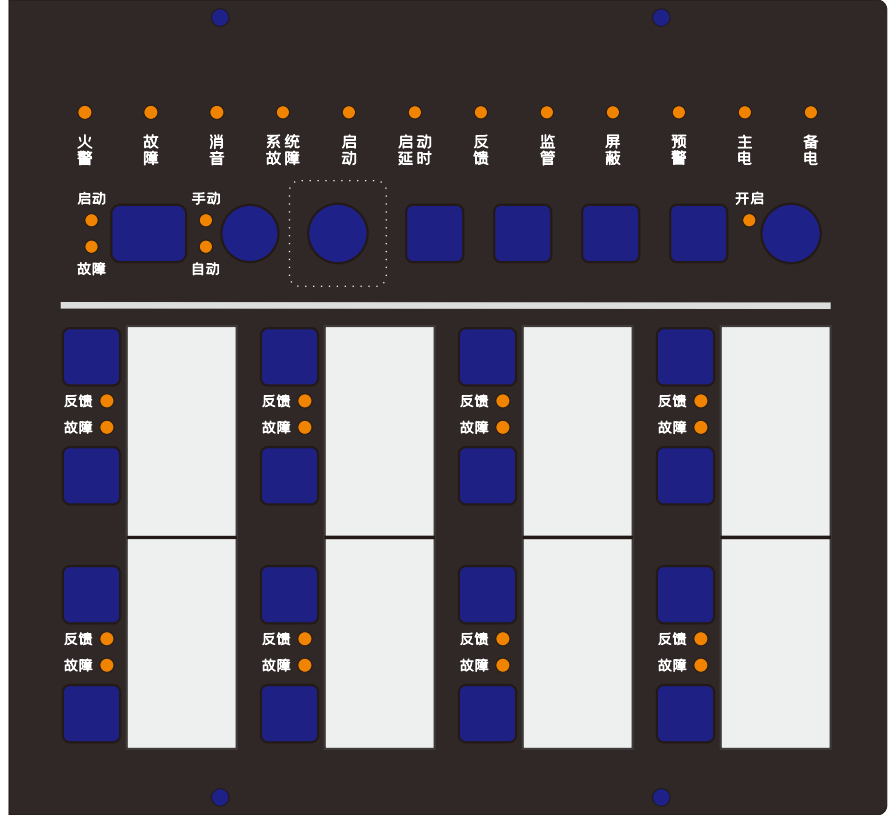
[picture p37: page 2]

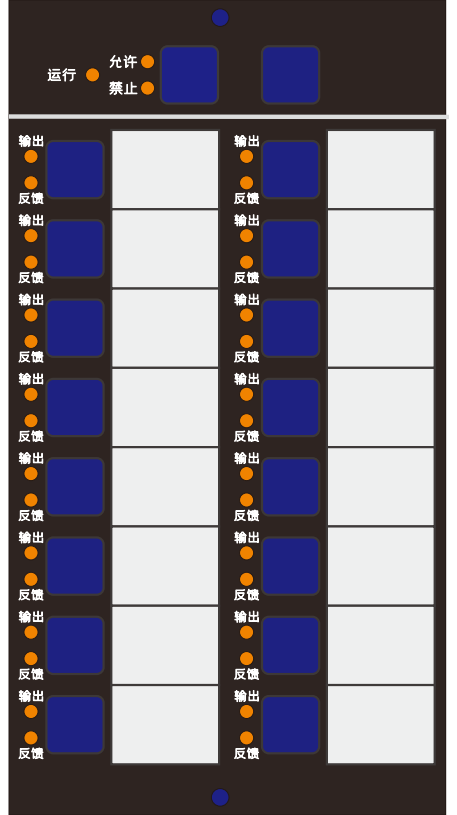
[picture p38: page 3]
