acssca/Oxygen/Mechanical/面板/新主机设计3.0版本03-12.pdf

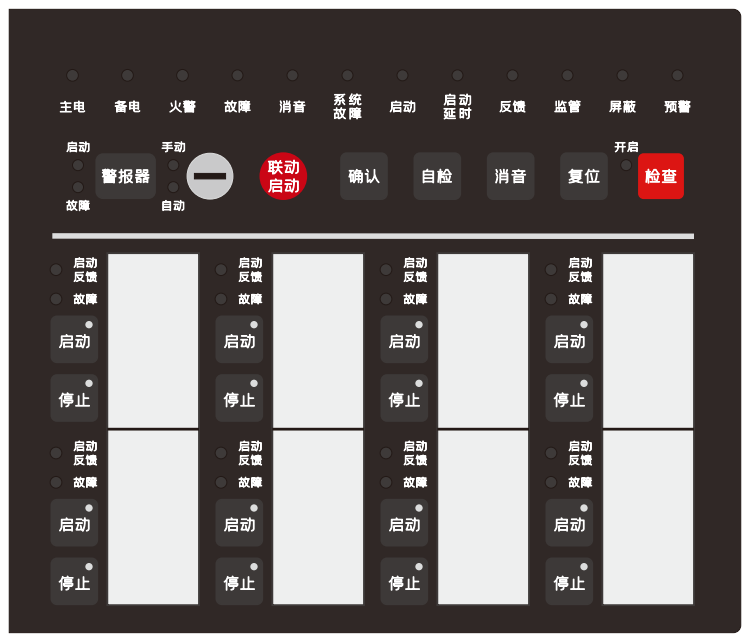
[picture p39: page 1]
警报器

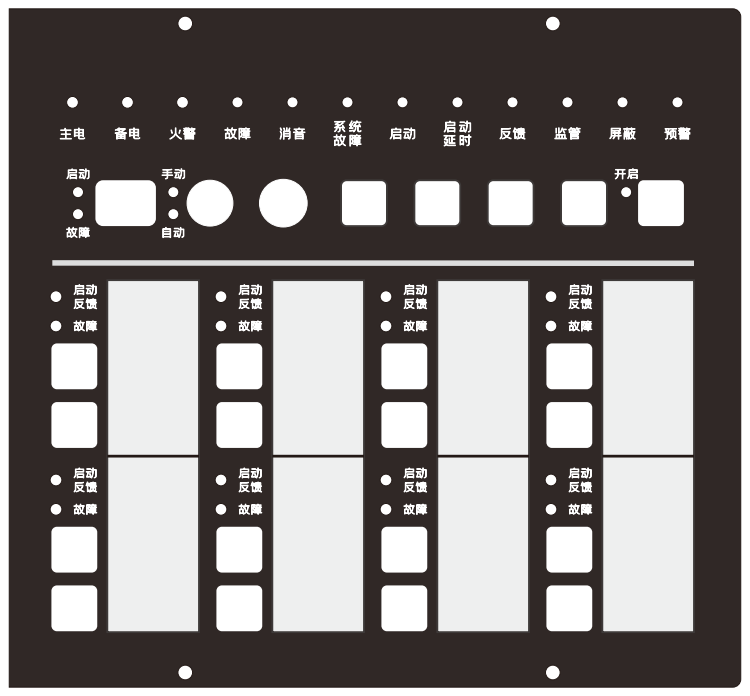
[picture p40: page 2]

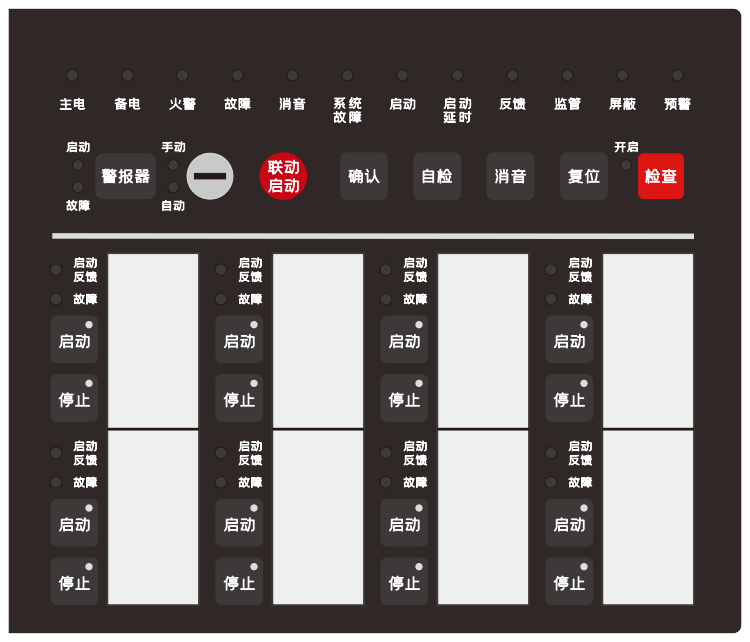
[picture p41: page 3]
警报器
