acssca/Oxygen/Mechanical/面板/新主机设计3.0版本03-15.pdf

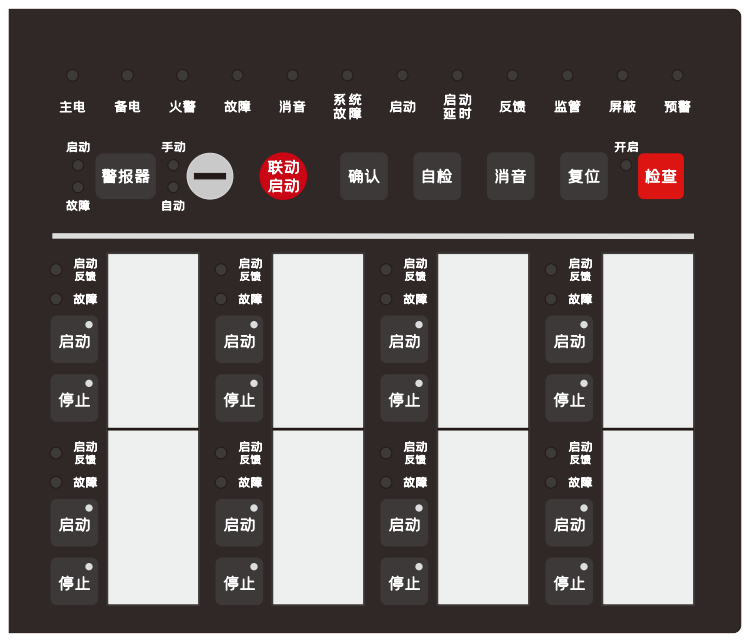
[picture p42: page 1]
警报器

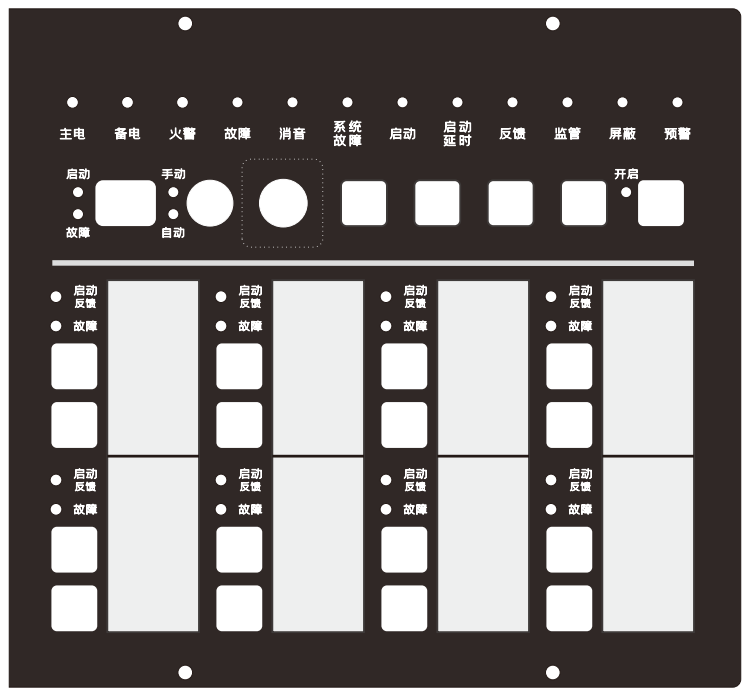
[picture p43: page 2]

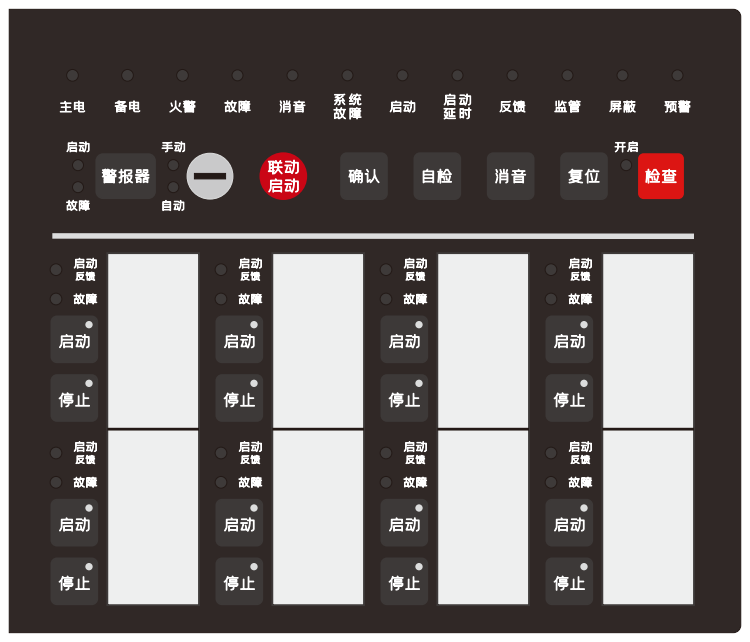
[picture p44: page 3]
警报器

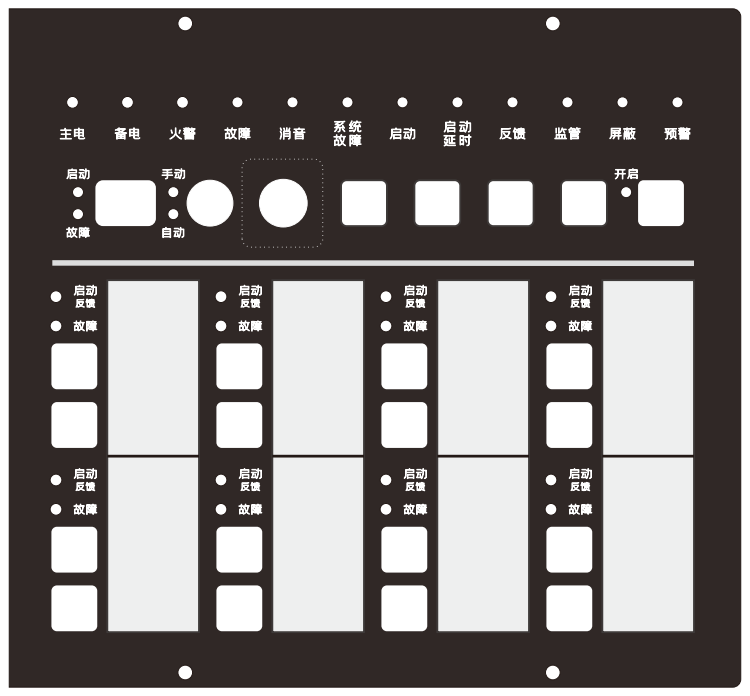
[picture p45: page 4]
