acssca/Oxygen/(list of files, drawings)

Other design files:
Hardware/Main Board/V1.0/MBOARD.DSN
Hardware/Main Board/V1.0/mboard.opj
