acssca/Oxygen/(commit log)

2021-02-25 Create 4. GB 4717-201X_火灾报警控制器（报批稿20210209）.docx
2021-02-25 add folder
    [Design Changes for New CCCF.xlsx, N-6000P-20190311.dwg]
2021-03-17 add some files
    add some files
    [MBOARD.DSN, PTWxxx_MB_V1.0_BOM_20210205.xlsx, mboard.opj]
2023-11-02 Create GA1061-2013 消防产品一致性检查要求.pdf
